Curedbio/Microscope/README.md

# Smartphone-Microscope
Microscope for any smartphone
