Curedbio/Microscope/V2/Microscopio_3mm_MDF_v021.pdf

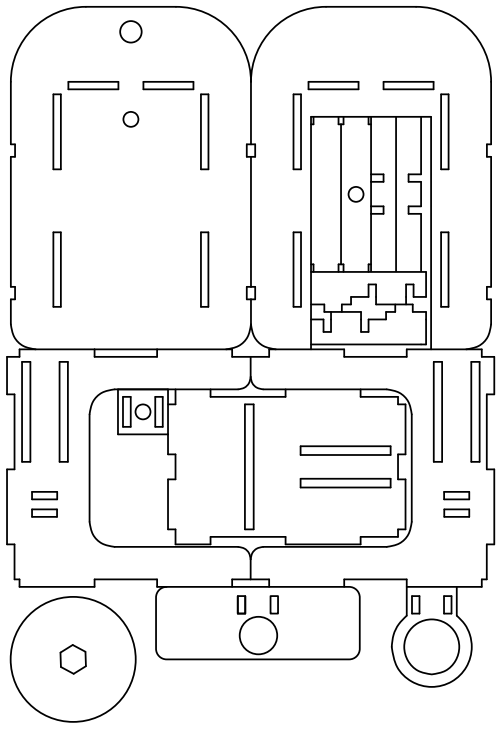
[picture p1: figure]
