Curedbio/Microscope/V1/model_v01.pdf

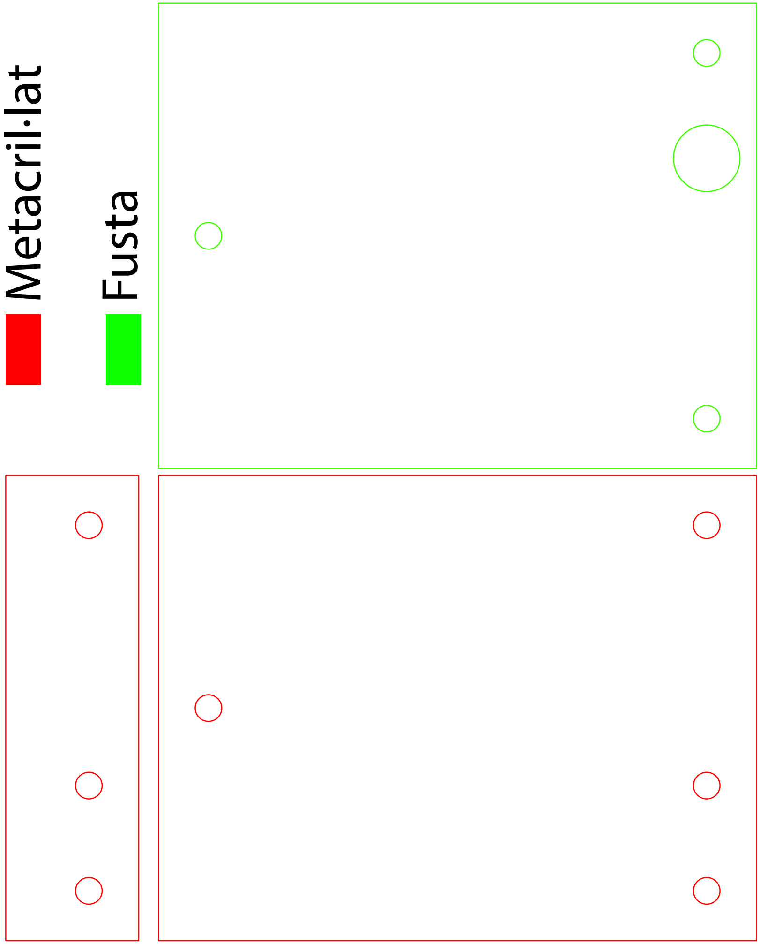
[picture p2: figure]
Metacril·lat; Fusta
