Curedbio/Microscope/V2/Microscopio_3mm_MDF_v021.dxf

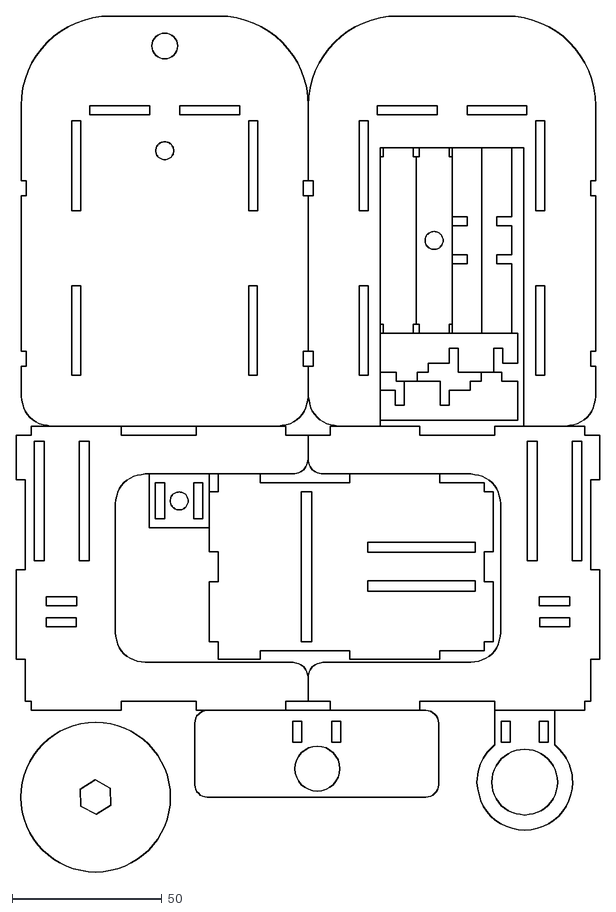
[picture p3: CAD file, 2019-03-04]
V2/Microscopio_3mm_MDF_v021.dxf
194.8 x 286.0
