Curedbio/Microscope/V2/STL/Microscopio_Lateral2_3.stl

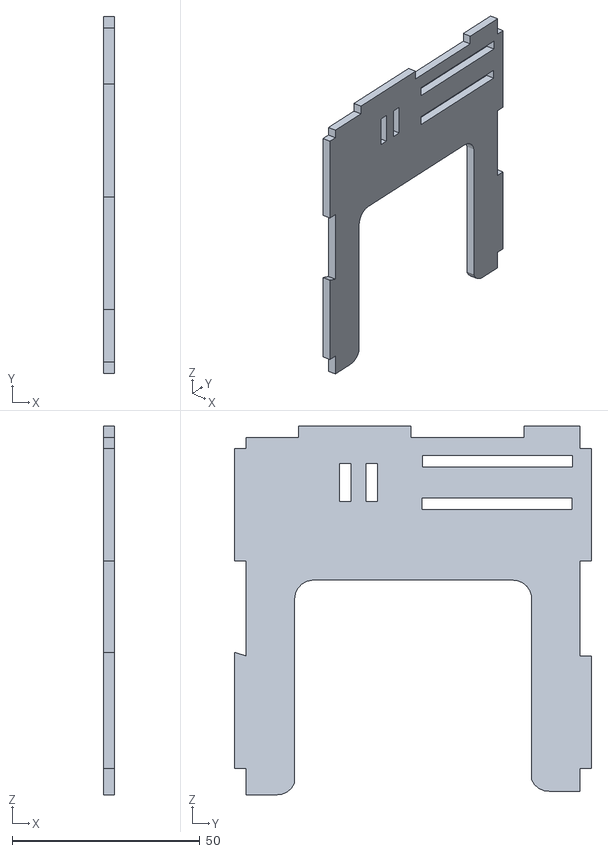
[picture p4: CAD file, 2018-02-19]
V2/STL/Microscopio_Lateral2_3.stl
3.00 x 95.0 x 98.1
