Curedbio/Microscope/V2/led_holder_v1-0.stl

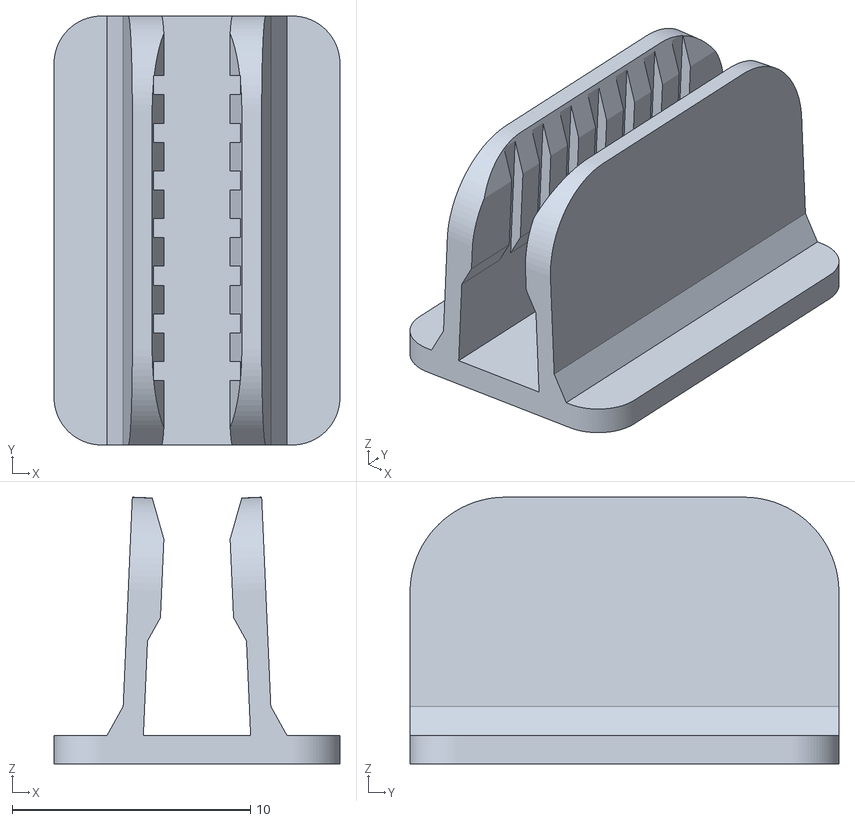
[picture p5: CAD file, 2019-03-04]
V2/led_holder_v1-0.stl
12.0 x 18.0 x 11.2
