Curedbio/Microscope/V2/STL/Microscopio_Support_Down_Down_5.stl

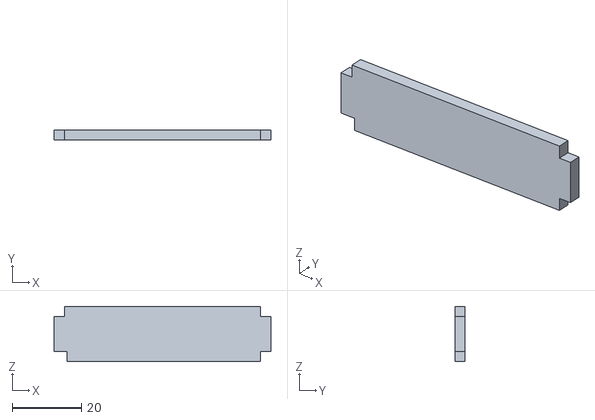
[picture p6: CAD file, 2018-02-19]
V2/STL/Microscopio_Support_Down_Down_5.stl
62.7 x 3.00 x 16.0
