Curedbio/Microscope/V2/STL/Microscopio_Wheel_6.stl

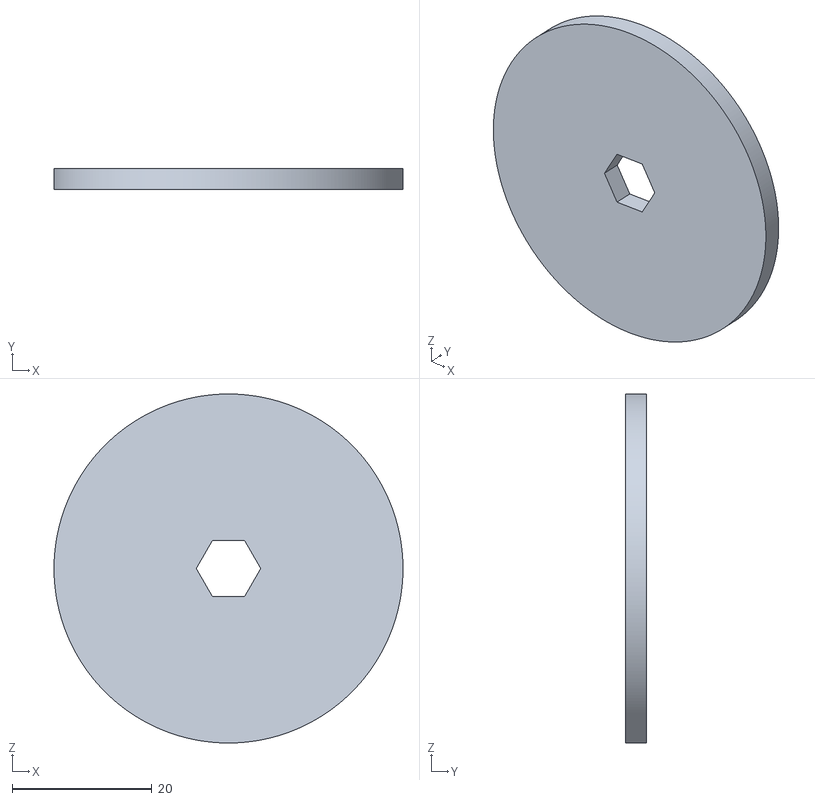
[picture p7: CAD file, 2018-02-19]
V2/STL/Microscopio_Wheel_6.stl
50.0 x 3.00 x 50.0
