Curedbio/Microscope/V2/STL/Microscopio_Square_Union_10.stl

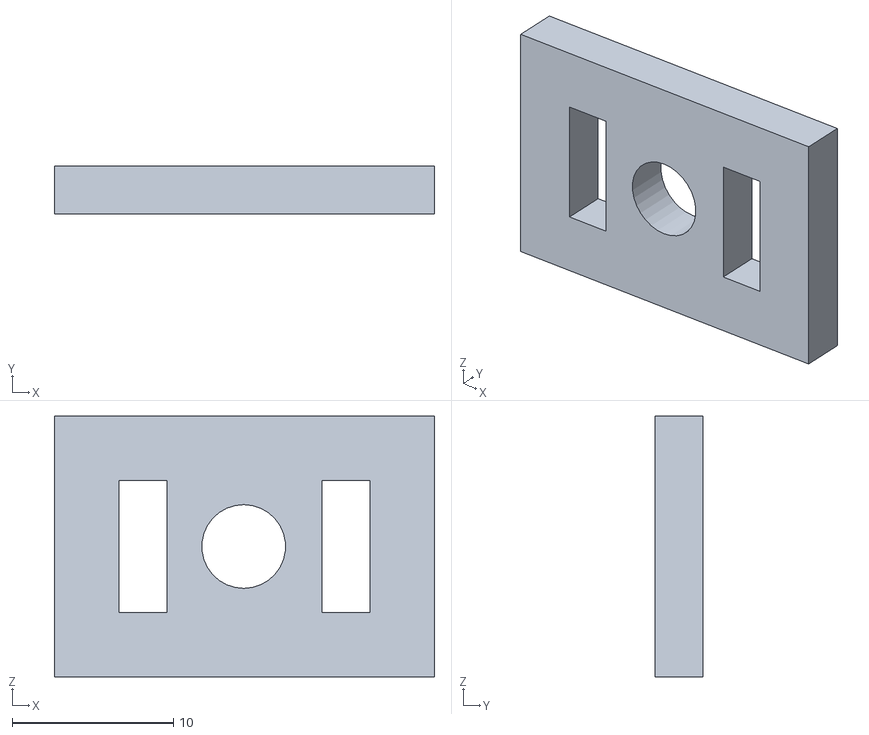
[picture p8: CAD file, 2018-02-19]
V2/STL/Microscopio_Square_Union_10.stl
23.6 x 3.00 x 16.2
