Curedbio/Microscope/V2/STL/Microscopio_Support_Trans_9.stl

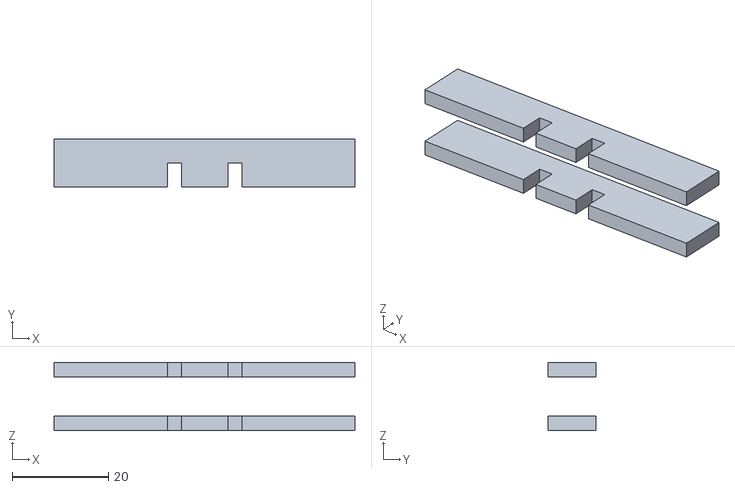
[picture p10: CAD file, 2018-02-19]
V2/STL/Microscopio_Support_Trans_9.stl
62.7 x 10.0 x 14.2
