Curedbio/Microscope/V2/STL/Microscopio_Slide_12.stl

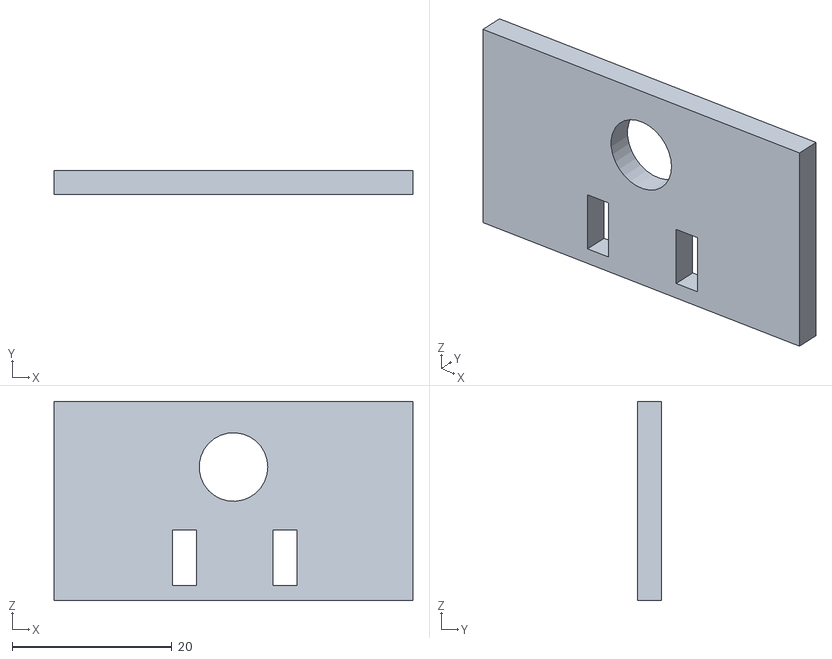
[picture p11: CAD file, 2018-02-19]
V2/STL/Microscopio_Slide_12.stl
45.0 x 3.00 x 25.0
