Curedbio/Microscope/V2/STL/Microscopio_Top_11.stl

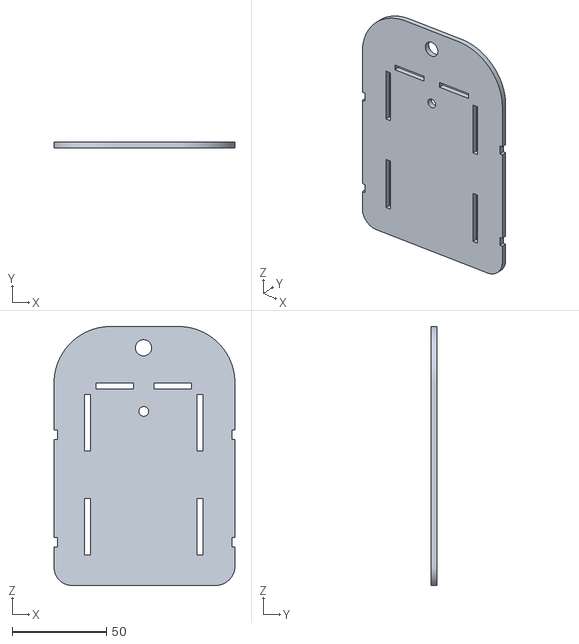
[picture p12: CAD file, 2018-02-19]
V2/STL/Microscopio_Top_11.stl
96.0 x 3.00 x 137.4
