Curedbio/Microscope/V2/STL/Microscopio_Support_Up_Left_8.stl

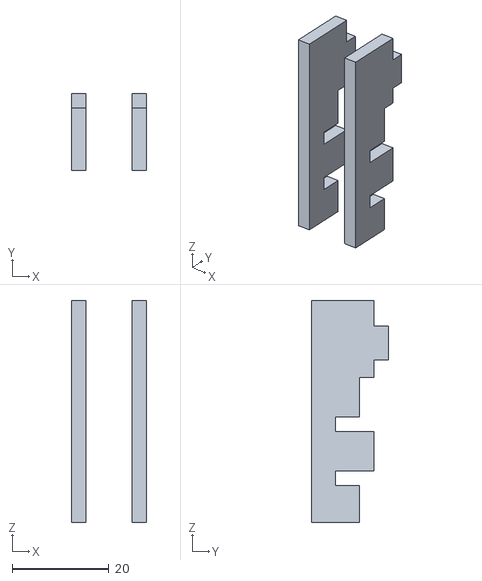
[picture p13: CAD file, 2018-02-19]
V2/STL/Microscopio_Support_Up_Left_8.stl
15.6 x 16.0 x 46.0
