Curedbio/Microscope/V2/STL/Microscopio_Frontal_4.stl

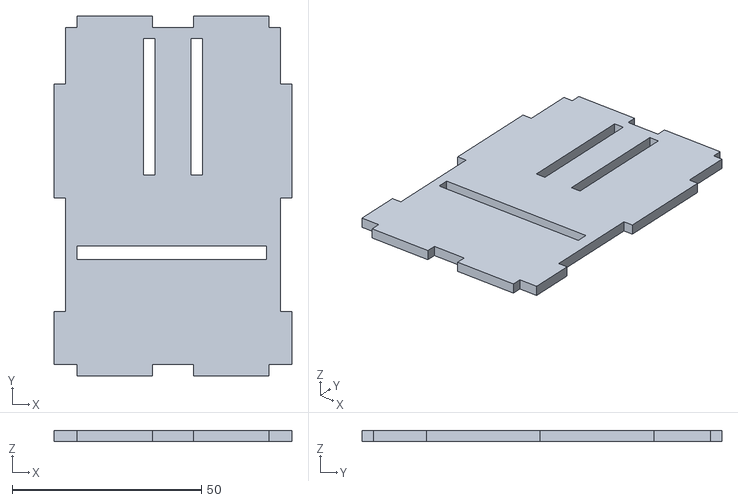
[picture p14: CAD file, 2018-02-19]
V2/STL/Microscopio_Frontal_4.stl
62.7 x 95.0 x 3.00
