Curedbio/Microscope/(list of files, cad)

Other CAD files:
V2/STL/Microscopio_Lateral1_2.stl
V2/STL/Microscopio_Support_Down_Up_7.stl
