Curedbio/Microscope/Assembly_guide_v012_ESP.pdf

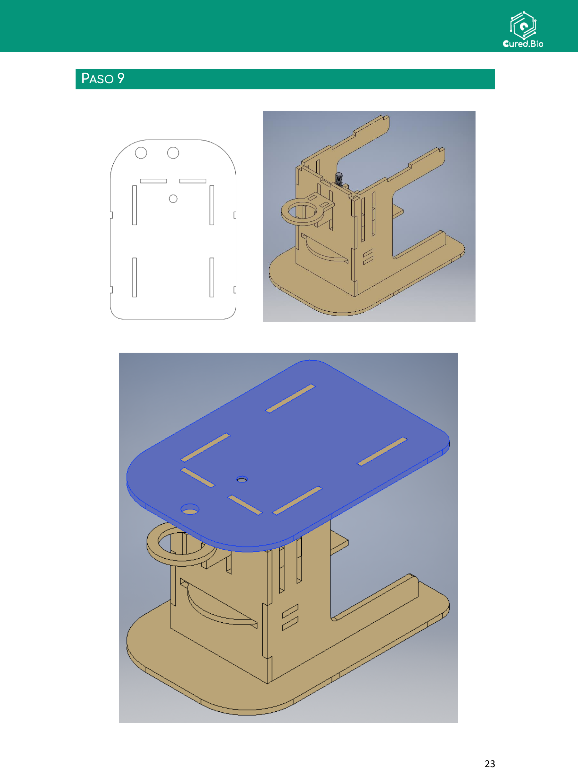
[picture p89: page 25]
