Curedbio/Microscope/Microscopy_Guide_Full_CAT_V1_V2.pdf

# SMARTPHONE MICROSCOPE

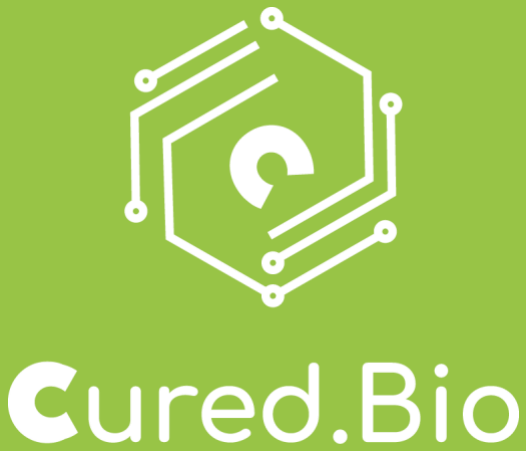
[picture p15: figure]

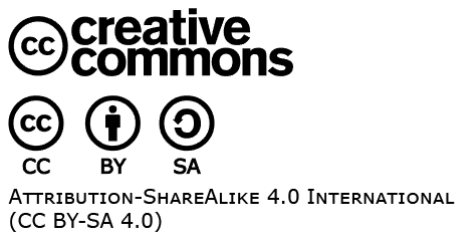
[picture p16: figure]

Smartphone Microscope
Derived from Microscopes by OpenStax Physics

Edited by Cured.Bio
Version 0.1.0
Barcelona, 2018

## ÍNDEX

# INTRODUCCIÓ A LA MICROSCÒPIA

INTRODUCCIÓ

Encara que l'ull és meravellós en la seva capacitat de veure objectes grans i petits, òbviament té limitacions als detalls més petits. El desig humà de veure més enllà del que és possible a simple vista va conduir al desenvolupament d'instruments òptics com el microscopi. Aquest instrument serveix per ampliar els detalls que no podem veure amb l’ull nu.

Bàsicament, un microscopi es un sistema de lents i/o miralls, on la imatge formada pel primer element es converteix en l'objecte del segon element, i així successivament. El microscopi mes basic consta de dues lents convexes.

### MICROSCOPI COMPOST

Els microscopis van ser desenvolupats a principis de 1600 per fabricants d'ulleres a Holanda i Dinamarca, amb el propòsit de visualitzar objectes petits mitjançant l’ús de diferents lents i/o miralls. El microscopi compost més simple es construeix a partir de dues lents convexes.

Una lent és un element, tradicionalment de vidre, destinat a fer convergir (concentrar) o divergir (dispersar) la llum. Les lents convexes són més gruixudes en el centre que no pas en els extrems. Aquestes lents fan convergir els raigs paral·lels en un punt anomenat punt focal (F’) i defineix la distància focal (f’), la qual es la distància entre el centre de la lent i el punt focal.

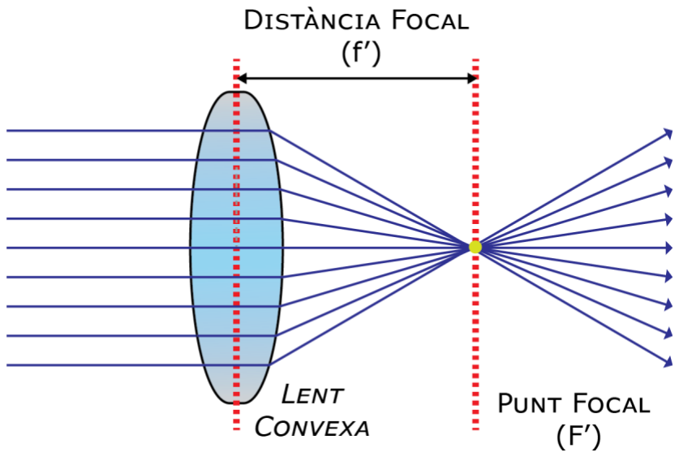
[picture p17: figure]

- Focus principal (F'): En una lent convergent el punt on coincideixen els raigs i per una divergent el punt con coincideixen les prolongacions del raig.
Tota lent té dos focus F i F'.
- Distància focal (f'): la distància des del focus al centre òptic

Potencia d’una lent
La diòptria és la unitat de mesura amb què s'expressa la potència d'una lent o d'un mirall corbat. Una lent convexa amb un major grau de curvatura, però fabricada amb el mateix material, tindrà una distància focal (f’) més curta i, per tant, serà una lent amb major capacitat de produir augments (diòptries, D).
La potència d'una lent es pot calcular utilitzant la següent fórmula:

D =

1
f

′

D’aquesta manera, una lent que té una distància focal de 0,1 metres té una potència de 10 diòptries.

Figura 1. Esquema lent convergent.

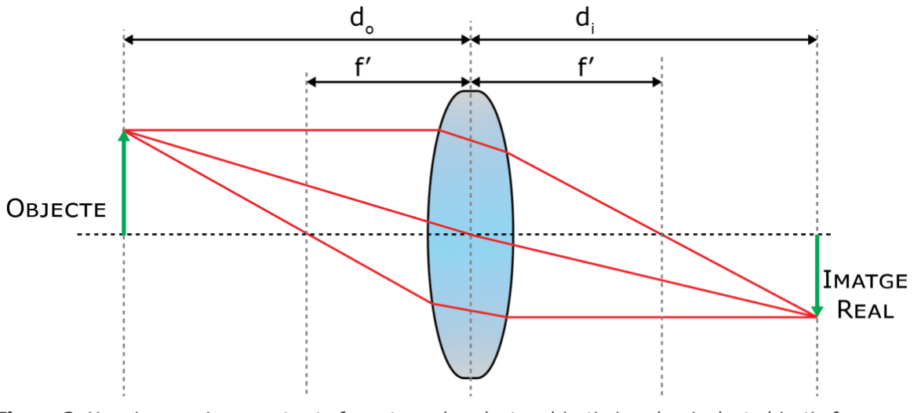
[picture p18: figure]

Figura 2. Un microscopi compost esta format per dues lents: objectiu i ocular. La lent objectiu forma una primera imatge més gran que l'objecte original. Aquesta imatge és ampliada per la lent ocular.

Si la distància des de un objecte fins l’objectiu es do i la distancia entre l’objectiu i la imatge creada es di, podem definir que:
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
Per tant, si un objecte es situat a una distància do>fo , es possible determinar a quina distancia es formarà la imatge (di).

En alguns casos di te un valor negatiu, la qual cosa indica que la imatge està formada al costat oposat de la lent des d'on s'estan considerant aquests raigs. Atès que els raigs de llum divergents que emanen de la lent no arriben mai a enfocar, i aquests raigs no estan físicament presents en el punt on semblen formar una imatge, això es coneix com una imatge virtual. Això és exactament el que fa l'ull quan mira a través d'una lupa. La lupa crea una imatge virtual (magnificada) darrere de la lupa, però aquests raigs es tornen a fotografiar per la lent de l'ull per crear una imatge real a la retina.

En un microscopi, la lent que es troba mes propera a la mostra s’anomena objectiu, i en microscopis normals sol tenir una ampliació de 5x a 100x i poden intercanviar-se. El segon, anomenat ocular, per trobar-se mes proper a l’ull, sol tenir una ampliació de 5x a 10x i es de tipus fix. Ambdues lents treballen de forma conjunta per a produir la imatge ampliada. A més, la imatge ampliada final es produeix en un lloc prou llunya per a que l'observador el pugui veure fàcilment, ja que l'ull no pot centrar-se en objectes o imatges massa properes.

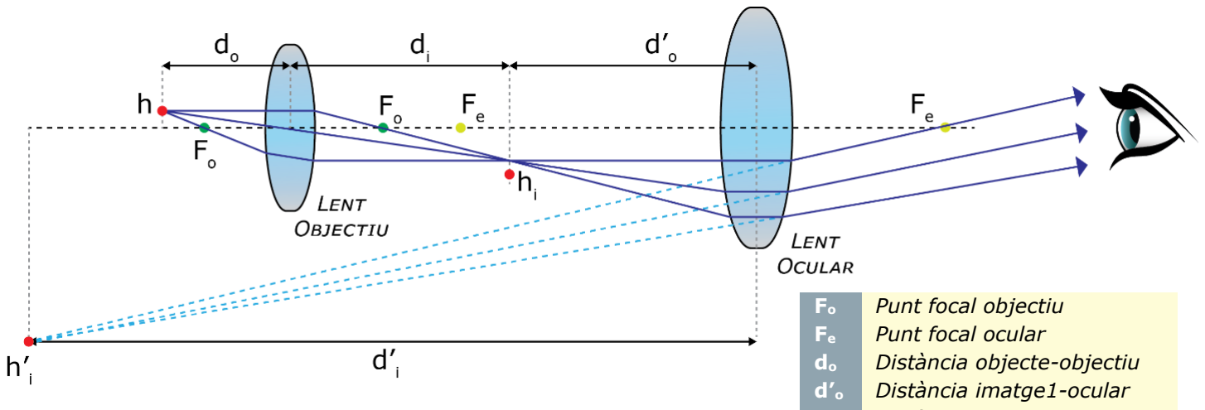
[picture p19: figure]
Punt focal objectiu; Punt focal ocular; Distància objecte-objectiu; Distància imatge1-ocular

Figura 3. Un microscopi compost esta format per dues lents: objectiu i ocular. La lent objectiu forma una primera imatge més gran que l'objecte original. Aquesta imatge és ampliada per la lent ocular.

Per entendre com un microscopi forma una imatge, tal com es mostra a la Figura 4, considerem dues lens convexes en successió. L’objecte (h) és troba a la distancia (d0) de la lent objectiu, que produeix una imatge real (hi) més gran que la mostra. Aquesta primera imatge (hi) és l'objecte de la segona lent (lent ocular). Aquesta lent esta situada per a què la primera imatge estigui més propera que la seva distància focal (Fe). D'aquesta manera, l'ocular actua com una lupa, i la imatge virtual es fa encara més gran.
La imatge virtual queda invertida, però és troba més allunyada de l'observador, cosa que facilita la visió (l'ull està més relaxat quan es visualitzen objectes distants i normalment no poden centrar-se més de 25 cm). Atès que cada lent produeix una ampliació , l'augment total
(m) és producte de les ampliacions individuals:

m = mo · me

on mo és l'augment de l'objectiu i me és l'augment de l'ocular. Aquesta equació es pot generalitzar per a qualsevol combinació de lents primes i miralls.

di | Distància objecte-objectiu
d’i | Distància imatge2-ocular
h | Objecte (mostra)
hi | Imatge real
h’i | Imatge virtual

### COM CALCULAR EL PODER D’AMPLIACIÓ D’UN MICROSCOPI

Calculeu l'ampliació (m) d'un objecte situat a 6.20 mm (do) d'un microscopi compost que té un objectiu amb una distancia focal de 6.00 mm (fo) i un ocular amb una distancia focal de 50.0 mm (d’i). L'objectiu i el ocular estan separats per 23.0 cm.

Estratègia i concepte
Aquesta situació és similar a la que es mostra a la Figura 3. Per trobar l'ampliació global, hem de trobar l'augment de la len ocular (mo) i el del la lent objectiu (me). Això implica l'ús de les equació esmentades.

Solució
L'augment de la lent objectiu es dóna com a

### m = mo · me

On la capacitat d’augment ve determinat per les diòptries (D) de la lent

D =

1
f

′

I on do es la distància focal de l’objectiu i di la distància la que es troba la imatge (hi), per a la len objectiu tal com s'indica a la Figura 4. La distància a la que es troba l’objecte es de 6.20 mm, però la distància a la que es produeix la imatge (di) no és coneguda. I on Fo és la distància focal de la lent objectiu.

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
Aïllant di, tenim que:

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
Per tant, podem definir m0 com a:
m0 = −

di
do

1
di

=

1
6. 00 mm

−

1
6. 20 mm

=

0. 00538
mm

Resolem i, per tant, di= 185.87 mm ≈ 186 mm.

Substituint aquest valor a l’equació per a mo,

m0 = −

di
do

= −

186 mm
6. 20 mm

= −30. 0

Ara, cal trobar l’ampliació de la len ocular (me), la qual ve donada per

me = −

di

′
do

′

on di' i do' són les distàncies d'imatge i objecte per a l'ocular (Figura 3). La distància de l'objecte és la distància de la primera imatge de l'ocular. Com que la primera imatge és a 186 mm de l'objectiu i l'ocular és a 230 mm respecte l'objectiu, la distància de l'objecte és (230 mm - 186 mm) de 44.0 mm. Això implica que la primera imatge es troba propera a l'ocular que la seva distància focal, de manera que l'ocular formarà una imatge (hi), tal com es mostra a la figura.

Per conèixer la ubicació de la imatge final, cal repetir les passes anterior per obtenir un valor de 1/di':

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
50. 0 mm

−

1
44. 0 mm

= −

0. 00273
mm

Resolem i, per tant, d’i = -366.30 mm ≈ -367 mm. Tornem a la primera equació i resolem per me,

me = −

di

′
do

′

= −

−367 mm
44 mm

= 8. 33

Ja nomes queda resoldre l’equació general,

## m = mo

- me = (−30. 0) · (8. 33) = −250

Discussió
Tant l'objectiu com l'ocular contribueixen a l'ampliació global, que és gran i negativa, d'acord amb la Figura 3, on la imatge es virtual i invertida. La imatge final és de 367 mm (0.367 m), formada a l'esquerra de l'ocular.
El procediment utilitzat per resoldre aquest exemple és aplicable en qualsevol sistema d'elements múltiples. Cada element es tracta respecte al seu torn, i cada un d'ells forma una imatge que es converteix en l'objecte del següent element.

# SMARTPHONE MICROSCOPE

### DESCRIPCIÓ

L’ Smartphone Microscope es un dispositiu open-source fabricat en fusta. Mitjançant l’ús d’una lent de 175x augments, es possible transformar qualsevol smartphone en un microscopi portàtil.
L’ Smartphone Microscope esta dissenyat per a poder ser ensamblat sense cap eina. A mes, es possible desensamblar-lo, facilitant el seu emmagatzematge (135x95x20mm). En cas de desitjar una estructura fixe, es recomana utilitzar cola d’enganxar o hot-glue.
No requereix instal·lar cap aplicació addicional, tan sols cal utilitzar alguna aplicació per fer fotografies o vídeos.
La qualitat de la imatge obtinguda depèn, en gran mesura, de les capacitats de la càmera de l’smartphone.

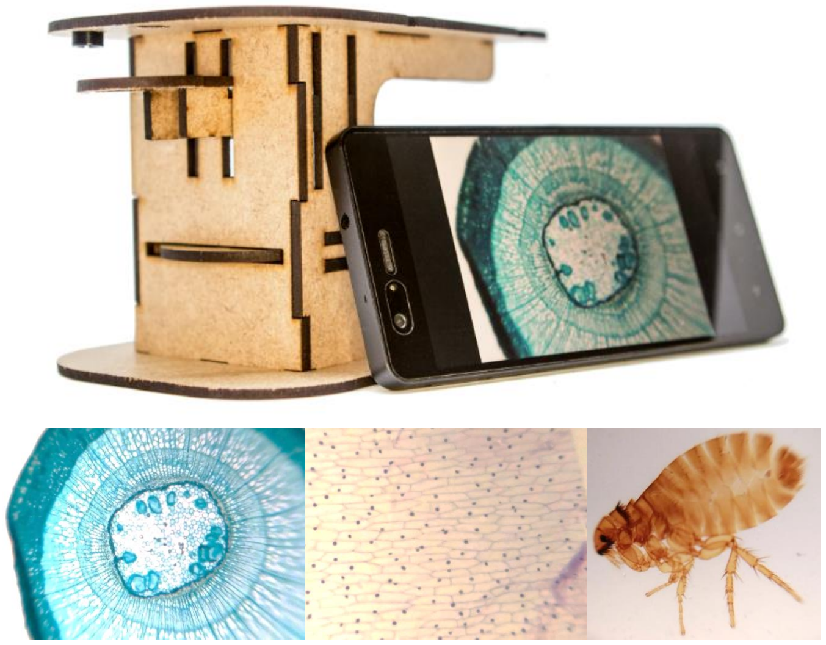
[picture p20: figure]

Imatges capturades amb BQ M5 i Open Camera v1.42

### COM FABRICAR-LO

L’Smartphone Microscope ha estat dissenyat per a poder ser fabricat mitjançant tècniques de fabricació tradicional o digital, ja sigui amb l’ajut d’una impressora 3D o una talladora làser.

Si es desitja seguir un mètode mes tradicional, cal adquirir fusta DM de 3mm de gruix, una mida similar a un DINA4. Aquest tipus de fustes es poden trobar Servei Estació (Barcelona) o grans magatzems (Leroy Merlin). Addicionalment, cal paper carbó per a calcar el disseny de les peces. Posteriorment, amb una serreta i paper de vidre poden retallar-se totes les peces necessàries.

En cas contrari, si es desitja utilitzar mètodes de fabricació digital, es pot utilitzar una impressora 3D o una talladora làser.
Si es disposar d’una impressora 3D, nomes cal imprimir els fitxers STL en plàstic PLA al 20% de refill. Depenent de la impressora, pot comportar mes o menys hores imprimir totes les peces.
Si es disposa d’una talladora làser, nomes cal utilitzar el fitxer PDF. Pot utilitzar-se fusta DM o metacrilat, ambdós de 3mm de gruix. El temps necessari depèn de la talladora làser utilitzada.

En cas de no disposar de cap de les dues, cal ser conscient que existeixen diferents entitats que poden oferir ambdós serveis. Tot i així, es recomana utilitzar una talladora làser. Alguns del llocs que podeu recórrer a Barcelona son:

- MADE MakerSpace: made-bcn.org
- Ateneus de fabricació: ajuntament.barcelona.cat/ateneusdefabricacio
- Punt Multimèdia: puntmultimedia.org

Trobareu els fitxers necessaris a www.github.com/curedbio.
Qualsevol dubte o petició, podeu contactar per mitja del correu electrònic info@cured.bio.

### COMPONENTS I ENSAMBLATGE

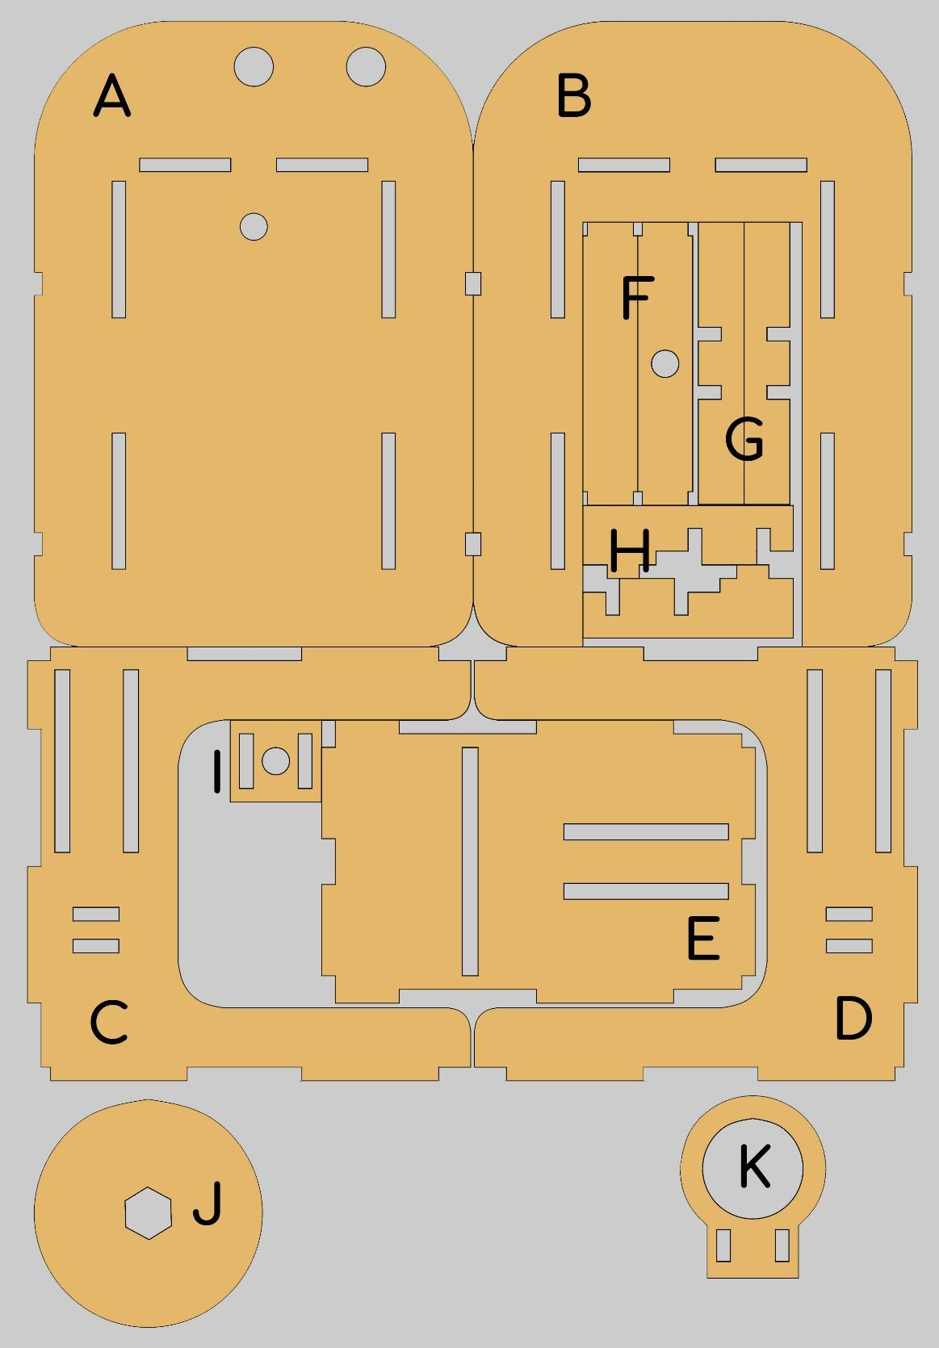
[picture p21: figure]

## M6*60mm

hexagonal | Femella M5 | Len

1

## Components G, H, I, rosca M5 hexagonal

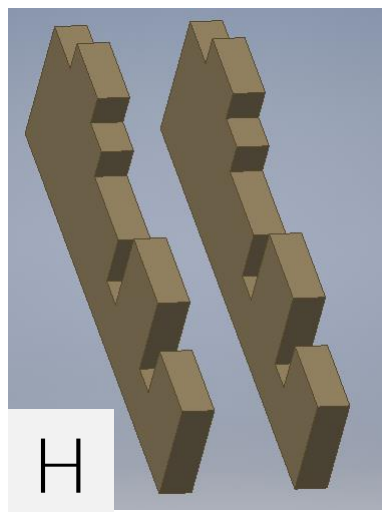
[picture p22: figure]
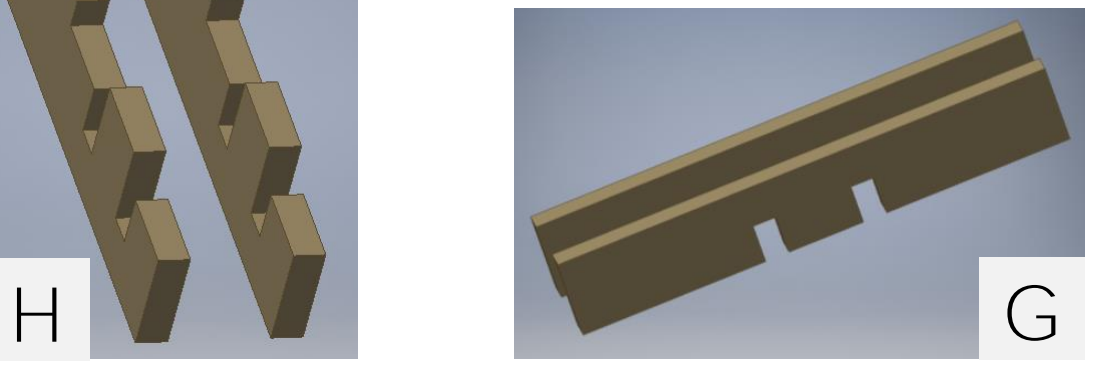
[picture p23: figure]
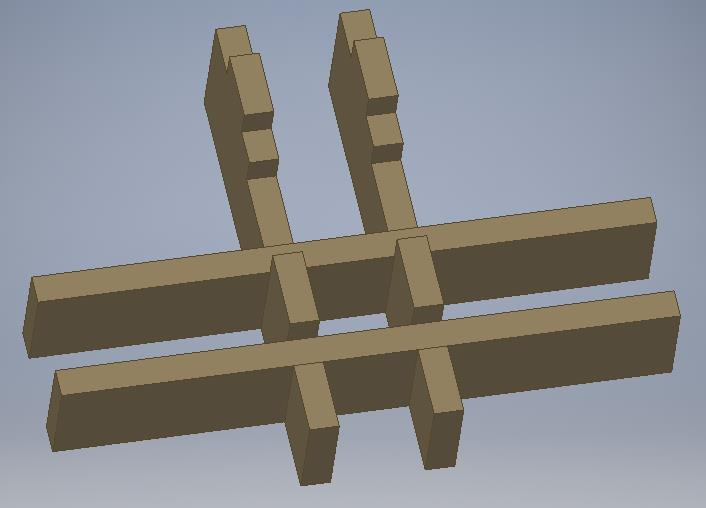
[picture p24: figure]
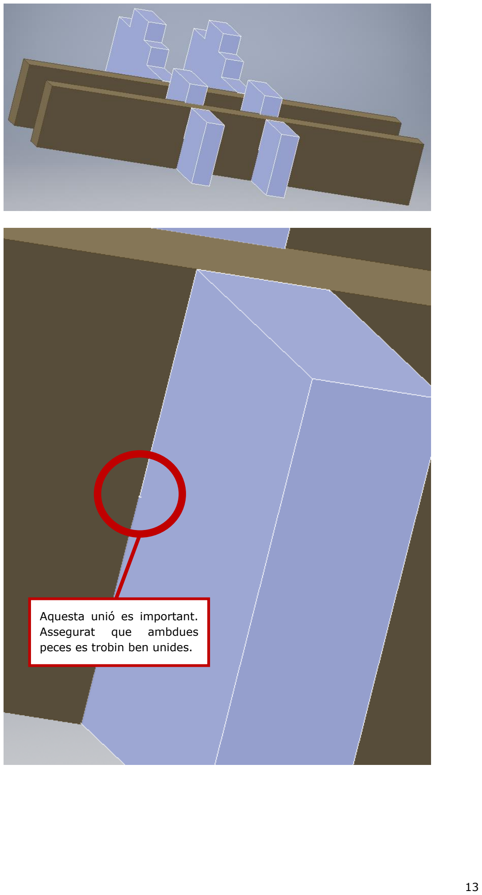
[picture p25: page 14]

Aquesta unió es important.
Assegurat | que | ambdues
peces es trobin ben unides.

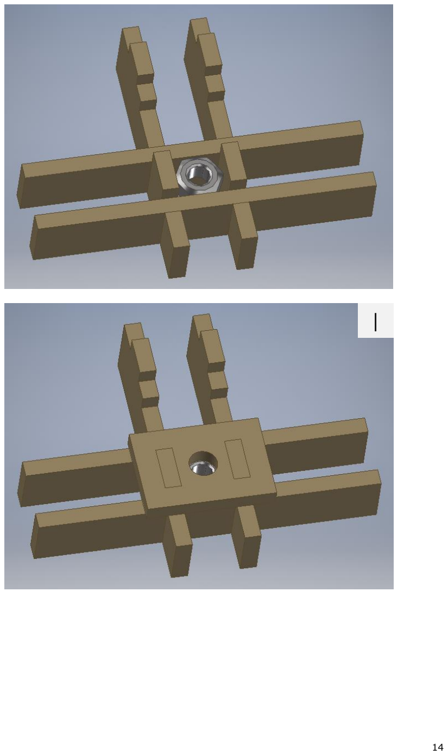
[picture p26: page 15]

I

2

## Components J, K, M6*60mm hexagonal

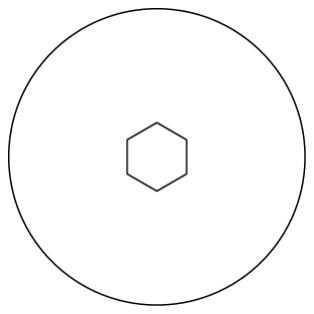
[picture p27: figure]
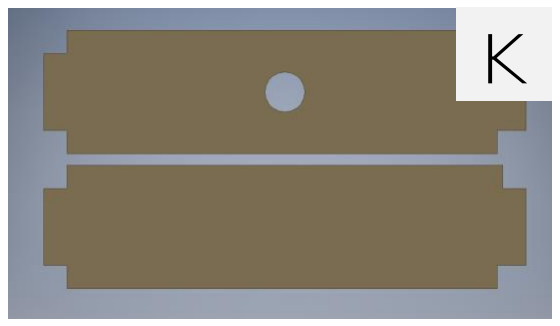
[picture p28: figure]
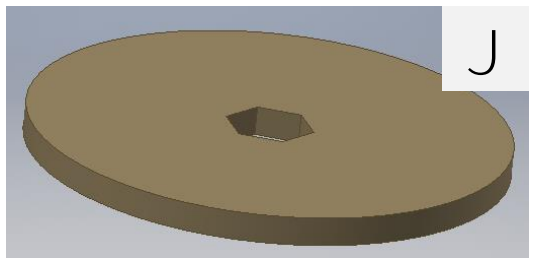
[picture p29: figure]
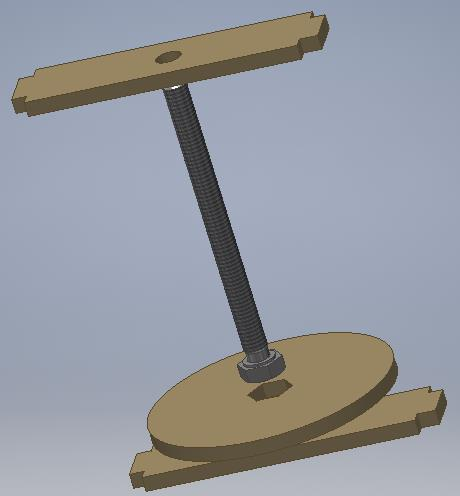
[picture p30: figure]
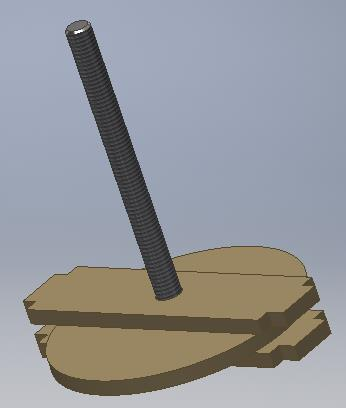
[picture p31: figure]

3

## Components 1, 2

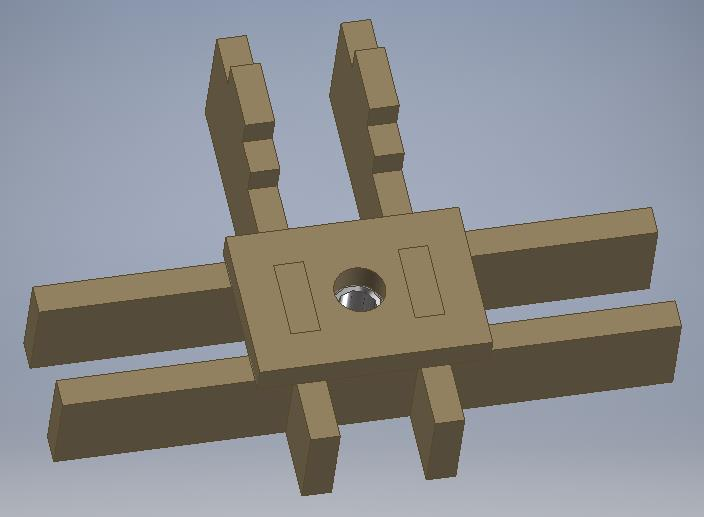
[picture p32: figure]
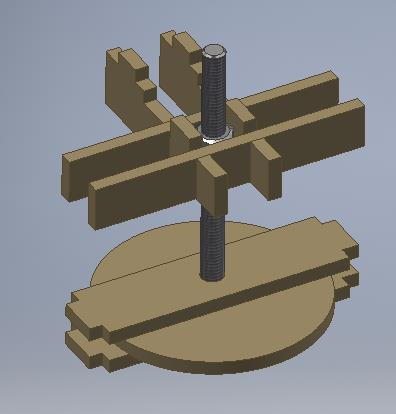
[picture p33: figure]

4

## Components E, 3

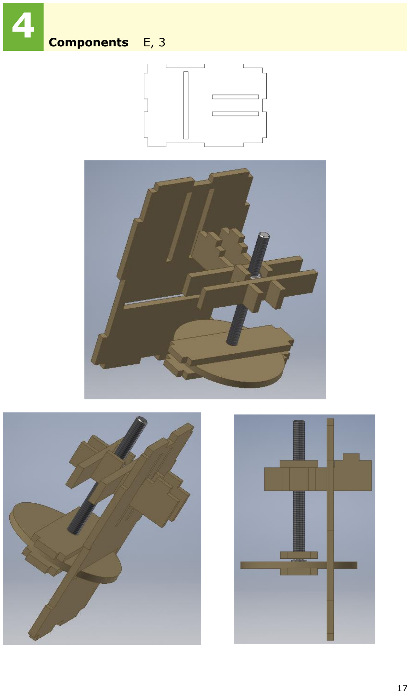
[picture p34: page 18]

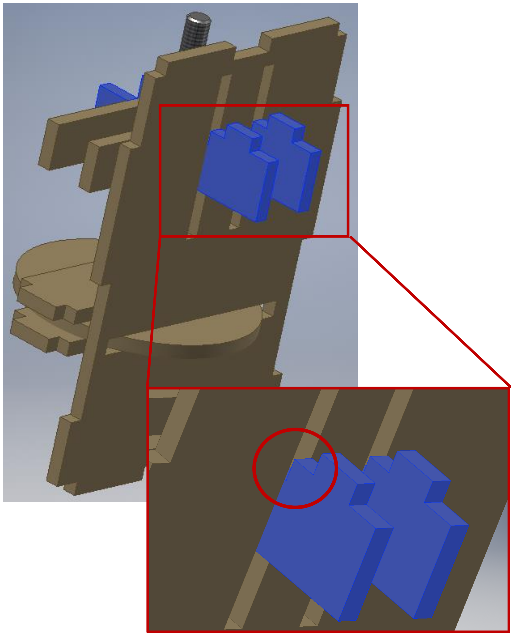
[picture p35: figure]

5

## Components C, D, 4

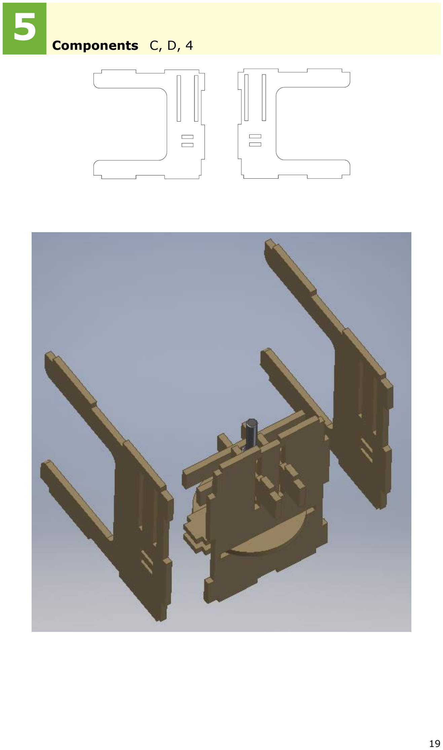
[picture p36: page 20]
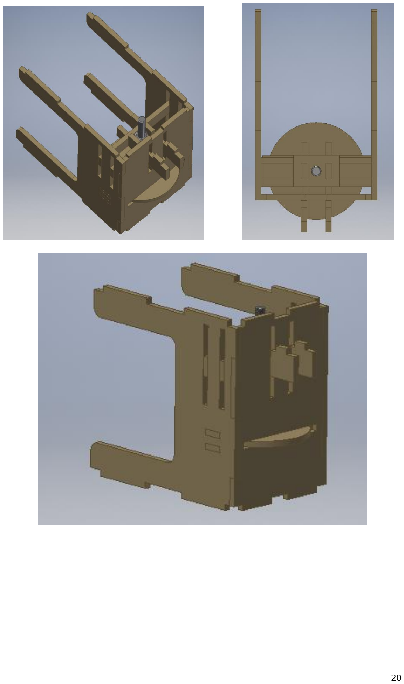
[picture p37: page 21]

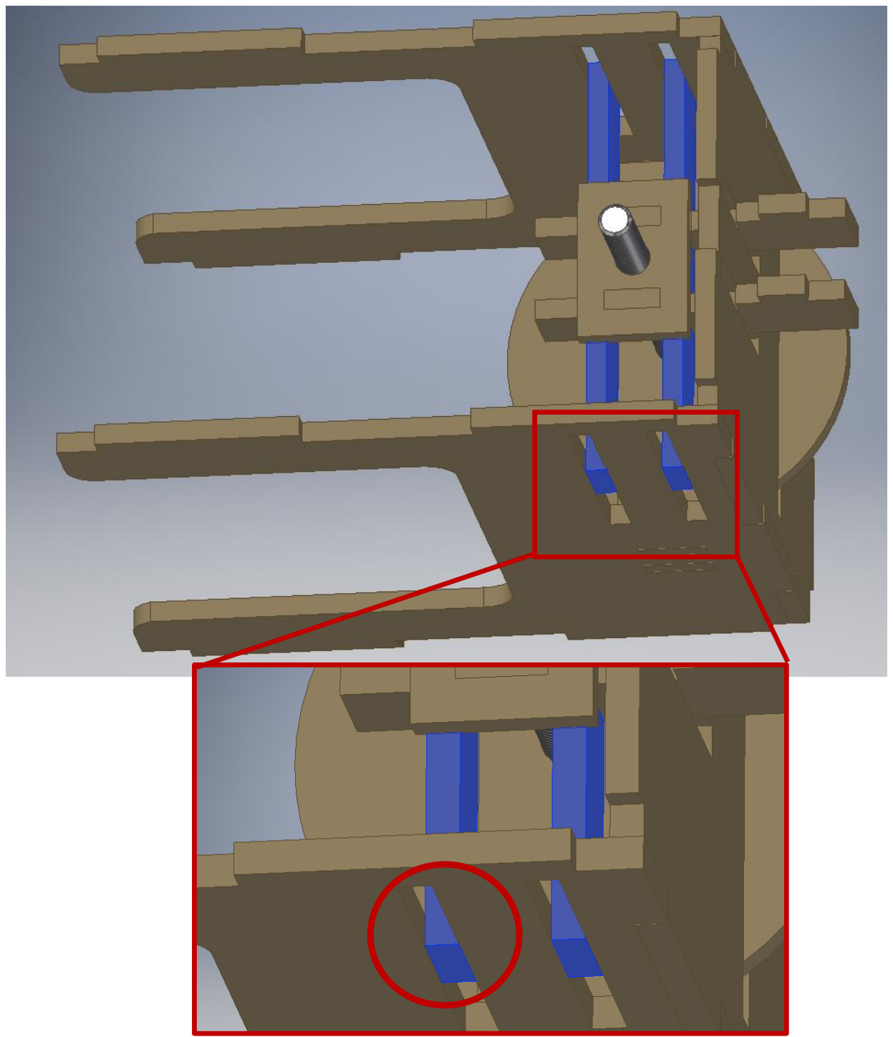
[picture p38: figure]

6

## Components A, B, 5, Len

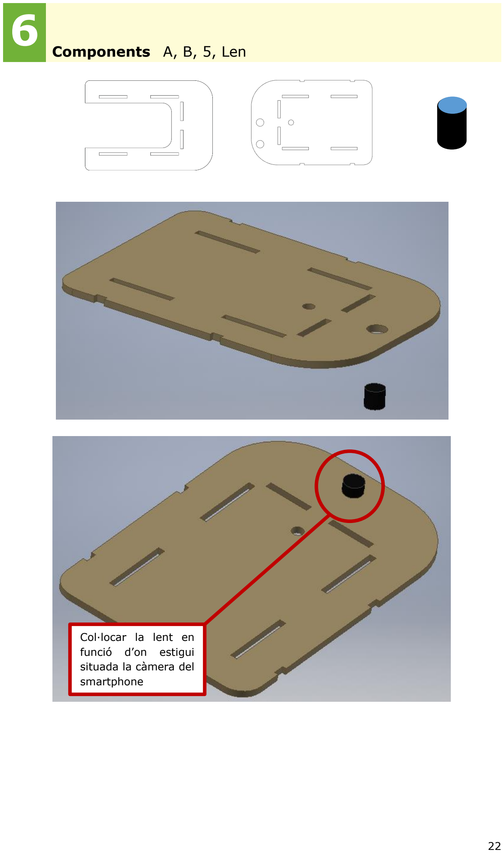
[picture p39: page 23]

Col·locar la lent en
funció d’on estigui
situada la càmera del
smartphone

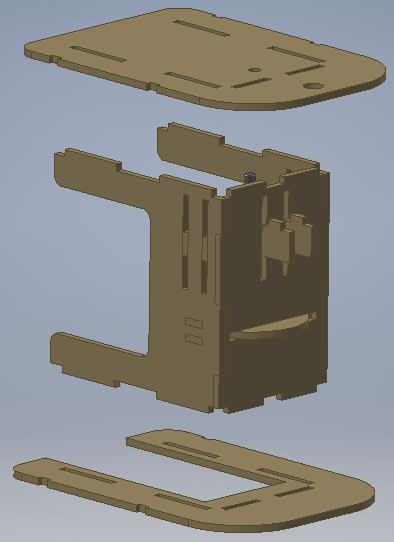
[picture p40: figure]
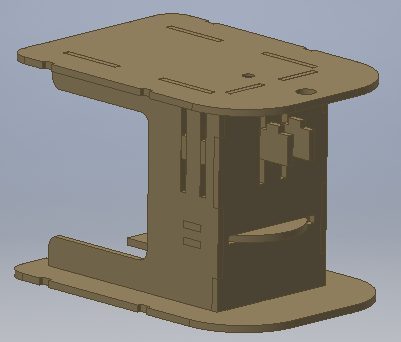
[picture p41: figure]

7

## Components K, 6

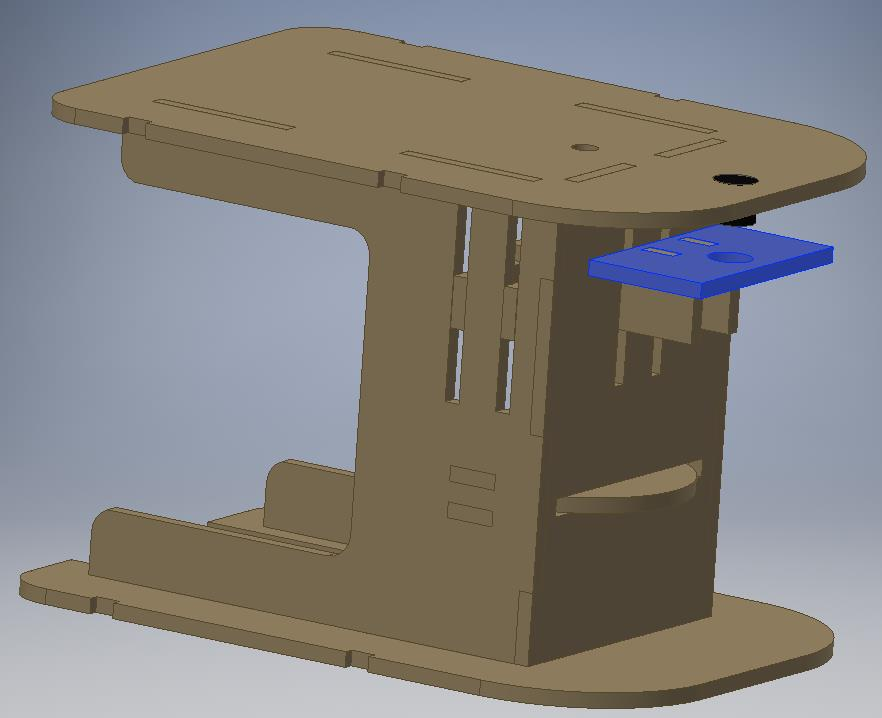
[picture p42: figure]

## 8 Observar el món microscòpic

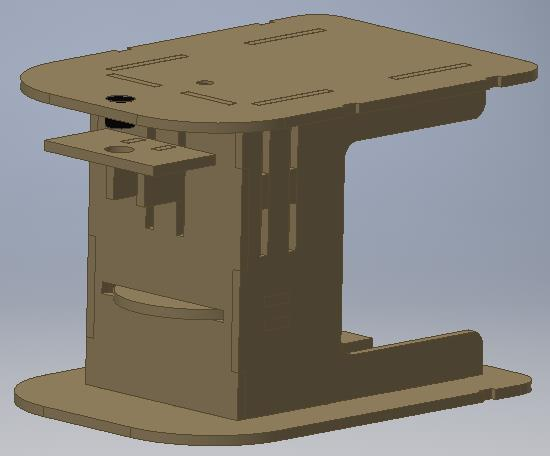
[picture p43: figure]

### MÒDUL LLUM

Smartphone Microscope esta dissenyat per a no requerir l’ús de llum directe. Tot i així, pot resultar interessant per als usuaris afegir un punt addicional de llum, per tal de millorar el contrast o visualitzar la mostra amb alguna longitud d’ona d’interès.

Una manera senzilla d’afegir un punt de llum es mitjançant una pila i un LED. De tal manera que es necessita:

### - Porta piles vertical CR2032 - Pila CR2032 - LED 3mm (llum blanca, per defecte)

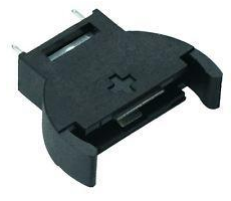
[picture p44: figure]
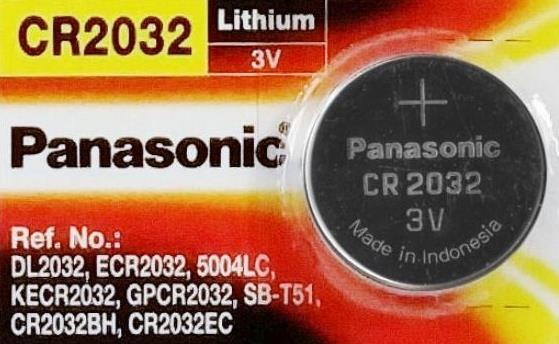
[picture p45: figure]

Cal clavar el porta piles a la base del microscopi, tal com es mostra en les figures que es troben a continuació.
Al col·locar el LED, cal vigilar amb el càtode (+) i l’ànode (-). Si al visualitzar la mostra, existeix un excés de llum, podem moure el LED o interposar algun full per reduir-ne la intensitat.

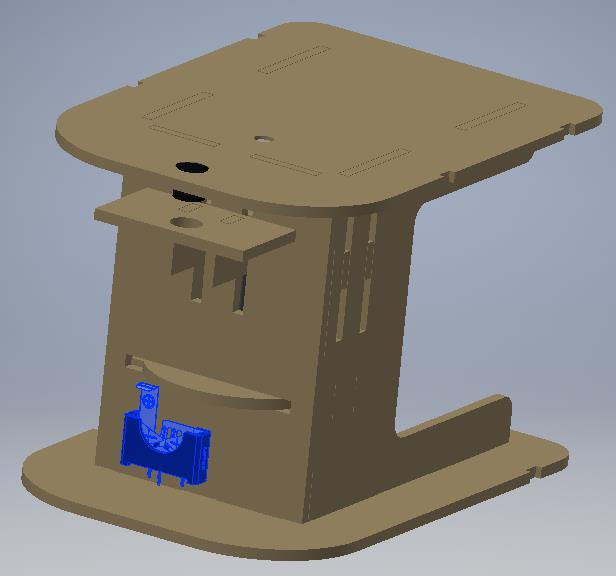
[picture p46: figure]
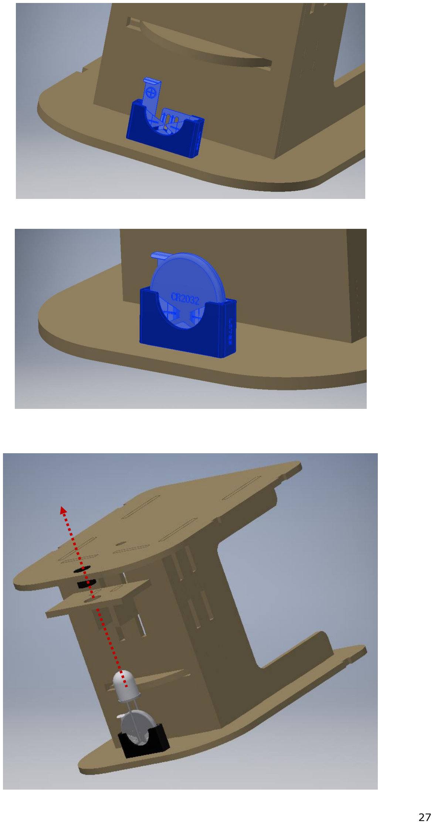
[picture p47: page 28]
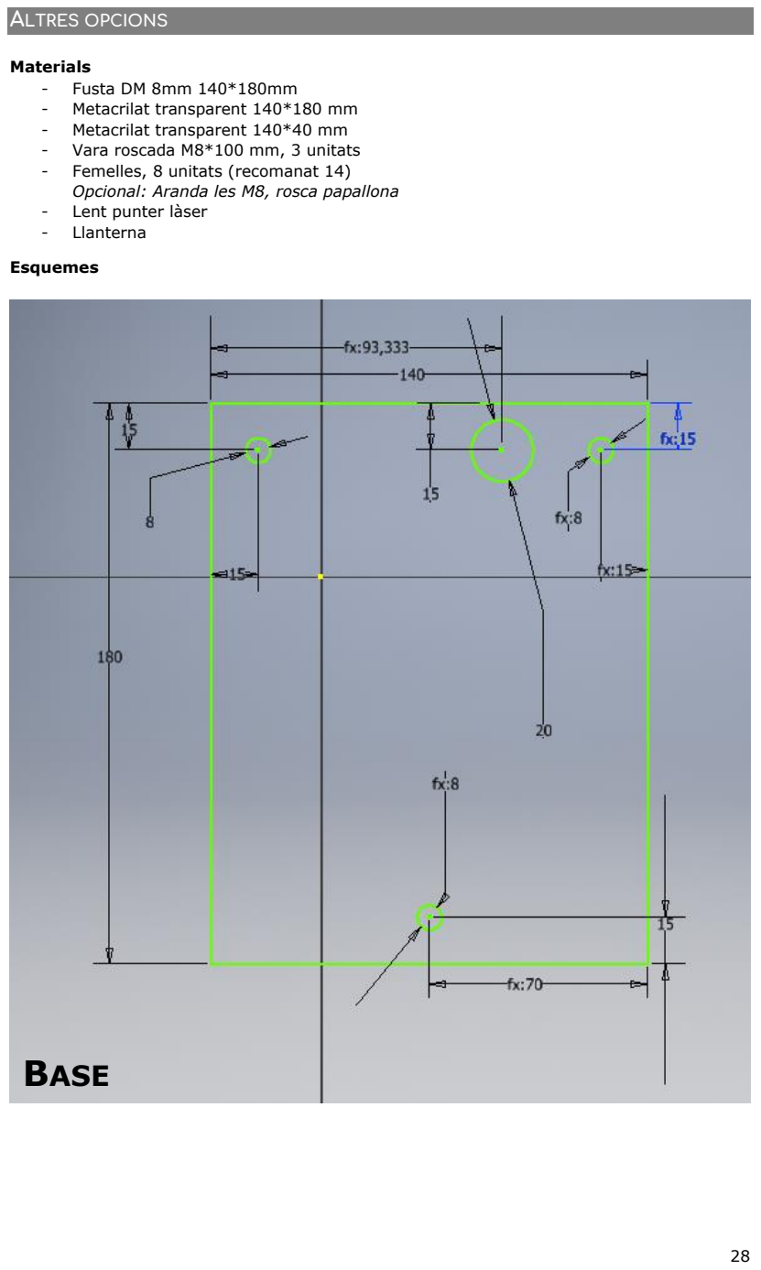
[picture p48: page 29]

### ALTRES OPCIONS

Materials
- Fusta DM 8mm 140*180mm
- Metacrilat transparent 140*180 mm
- Metacrilat transparent 140*40 mm
- Vara roscada M8*100 mm, 3 unitats
- Femelles, 8 unitats (recomanat 14) Opcional: Aranda les M8, rosca papallona
- Lent punter làser
- Llanterna

Esquemes

# BASE

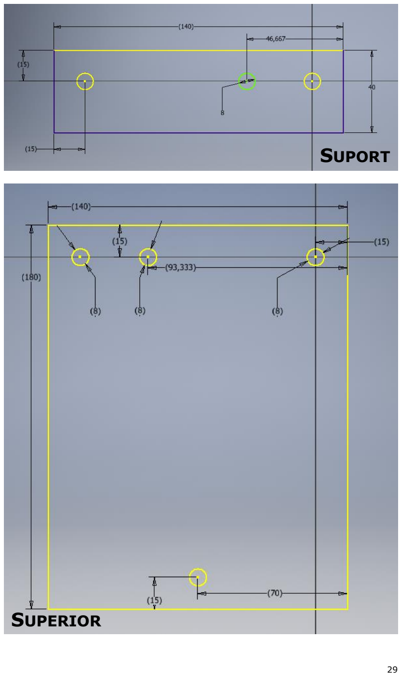
[picture p49: page 30]

# SUPORT

# SUPERIOR

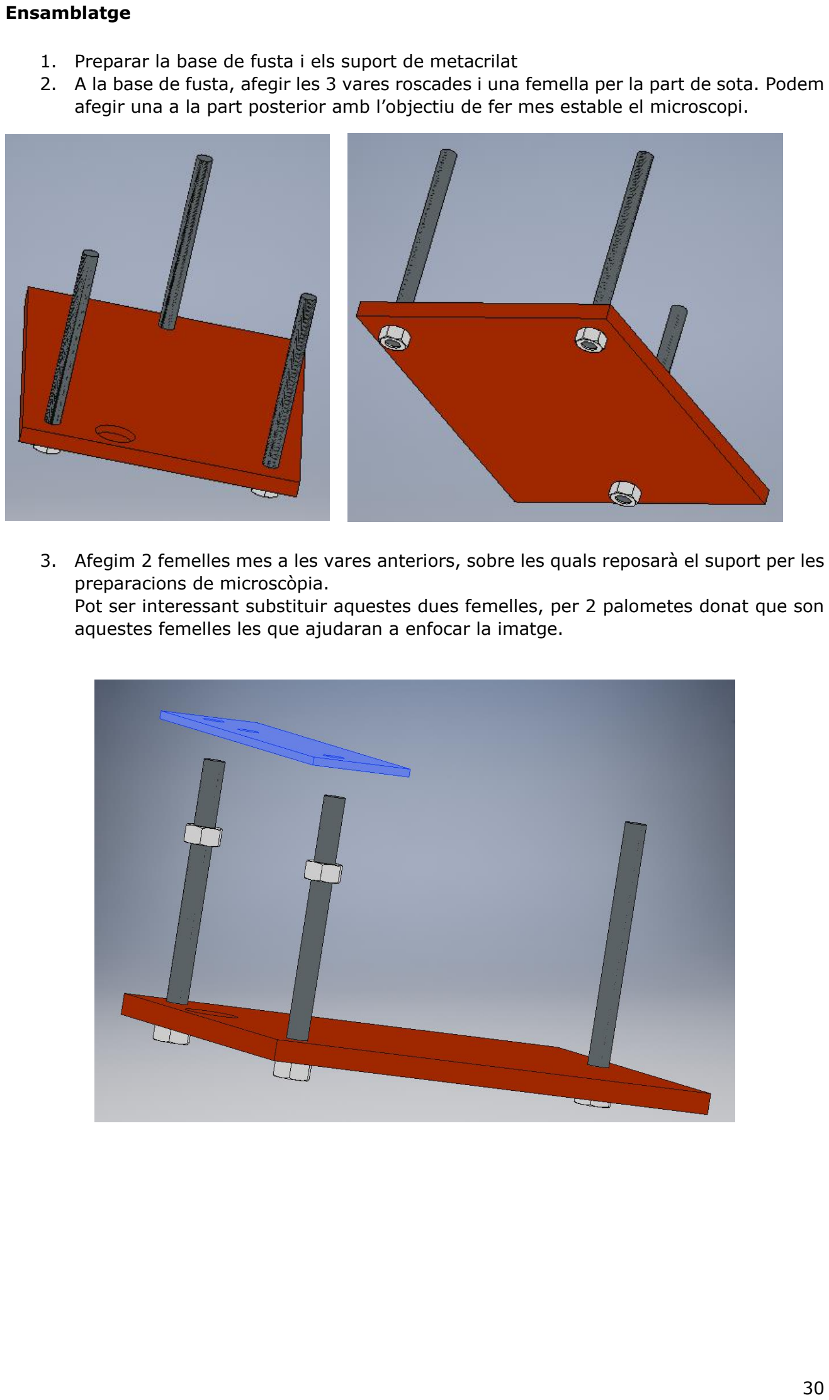
[picture p50: page 31]

Ensamblatge

1. Preparar la base de fusta i els suport de metacrilat
2. A la base de fusta, afegir les 3 vares roscades i una femella per la part de sota. Podem afegir una a la part posterior amb l’objectiu de fer mes estable el microscopi.
3. Afegim 2 femelles mes a les vares anteriors, sobre les quals reposarà el suport per les preparacions de microscòpia.
Pot ser interessant substituir aquestes dues femelles, per 2 palometes donat que son aquestes femelles les que ajudaran a enfocar la imatge.

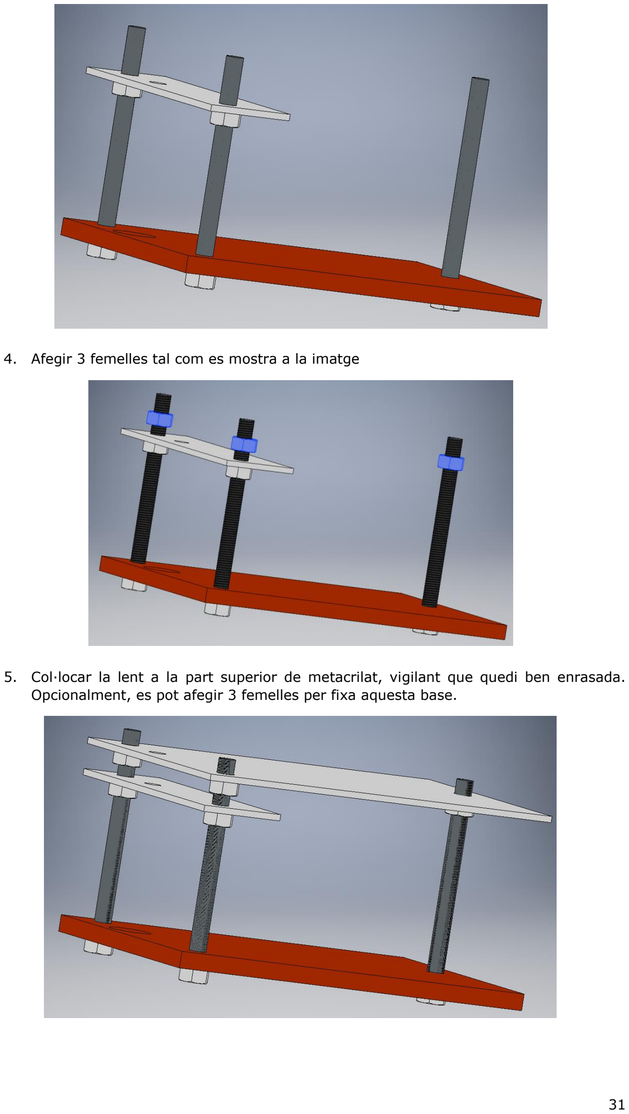
[picture p51: page 32]

4. Afegir 3 femelles tal com es mostra a la imatge
5. Col·locar la lent a la part superior de metacrilat, vigilant que quedi ben enrasada. Opcionalment, es pot afegir 3 femelles per fixa aquesta base.

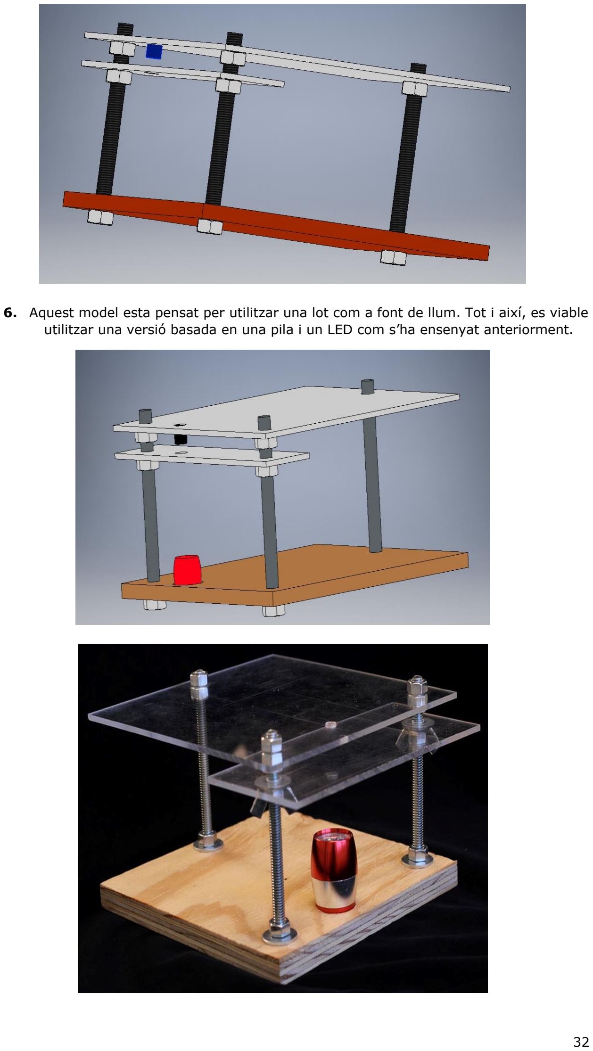
[picture p52: page 33]

6. Aquest model esta pensat per utilitzar una lot com a font de llum. Tot i així, es viable utilitzar una versió basada en una pila i un LED com s’ha ensenyat anteriorment.

Com obtenir una lent per al microscopi

Donat un punter lasar qualsevol, podem utilitzar la len convexa que incorpora per al microscopi.

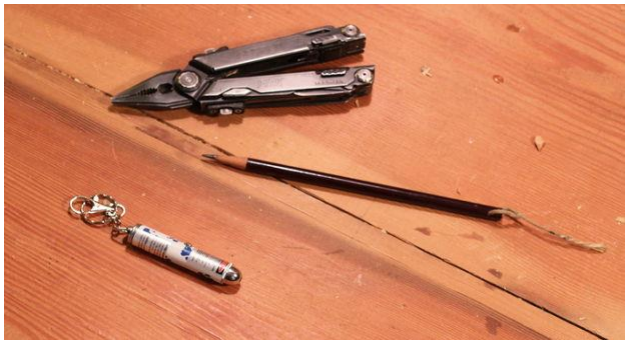
[picture p53: figure]
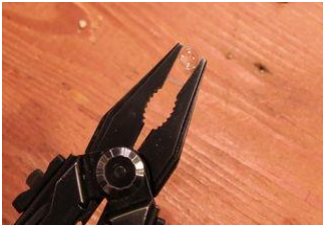
[picture p54: figure]

# PREPARACIONS PER AL MICROSCOPI

### CÈL·LULA ANIMAL: EPITELI MUCOSA ORAL

Les cèl·lules animals poden tenyir-se fàcilment mitjançant el blau de metilè. Aquest fet es degut a la permeabilitat de les seves membranes cel·lulars. El blau de metilè interacciona amb les molècules amb carrega negativa, com el DNA o el RNA.

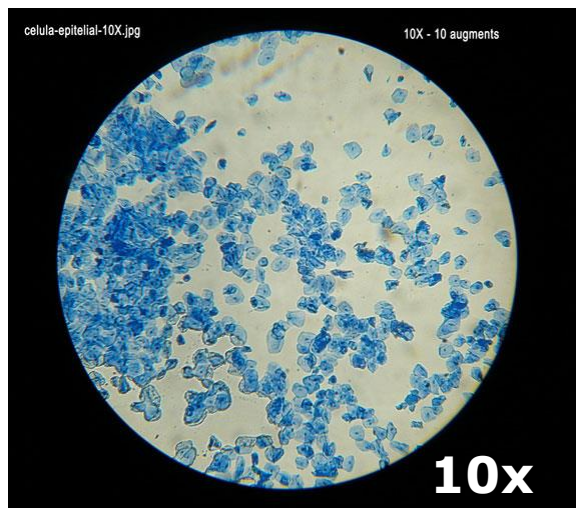
[picture p55: figure]

Materials
- Microscopi

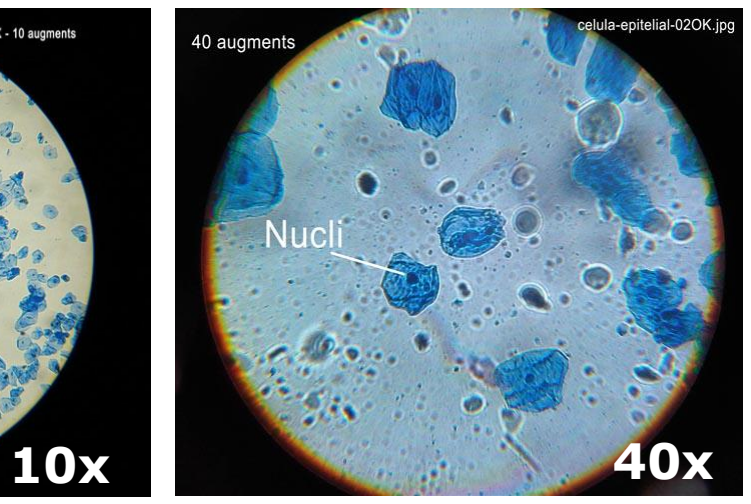
[picture p56: figure]

- Bastonet de cotó / Escuradents
- Portaobjectes i cobreobjectes
- Blau de metilè (0.5-1.0% solució stock, diluir a 1:4 amb H20).
- Bec bunsen
- Aigua destil·lada
- Pinces de fusta
- Vidre de rellotge / Placa de Petri

Protocol
1. Raspar amb un escuradents la mucosa interna de la galta de la boca, dipositant el producte extret en el centre d'un portaobjectes amb una gota d'aigua.
2. Realitzar una extensió més o menys uniforme, amb l'ajuda d'una agulla o un altre porta
3. Amb l’ajut d'unes pinces de fusta, escalfar suaument el portaobjectes per fixar la mostra, passant-lo per la flama de l'encenedor fins a la dessecació de l'extensió i evitant que el portaobjectes es s’escalfi excessivament (comprovar amb dors de la mà).
4. Col·locar el portaobjectes sobre el vidre de rellotge (o placa Petri) i afegir unes gotes de blau de metilè sobre l'extensió.
5. Incubar 2 minuts a temperatura ambient, i després rentar amb aigua destil·lada.
6. Retirar l’ excés d’aigua amb una mica de paper de filtre, per capil·laritat no arrossegament.
7. Observar la mostra al microscopi.

### CÈL·LULA VEGETAL: EPIDERMIS VEGETAL

La principal diferencia entre les cèl·lules animals i les vegetals rau en la membrana cel·lular. Primer de tot, realitzarem, una tinció de les cèl·lules per tal de visualitzar l’estructura del teixit. Posteriorment, s’observarà al microscopi com afecta la pressió osmòtica a les cèl·lules vegetals. Recorda que la concentració salina elevada (hipertònica) del medi fa que les cèl·lules perdin aigua per intentar equilibrar les concentracions interna i externa (plasmòlisis); i que la concentració salina molt diluïda del medi (hipotònica) fa que les cèl·lules absorbeixin aigua.

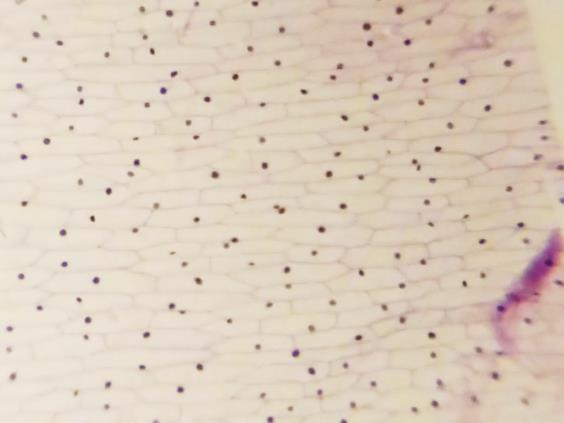
[picture p57: figure]

Materials
- Microscopi
- Ceba
- Portaobjectes i cobreobjectes
- Comptagotes

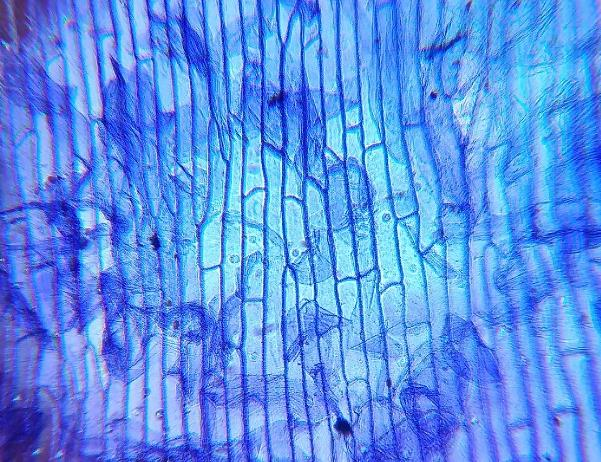
[picture p58: figure]

- Solució salina: hipertònica (6% NaCl), hipotònica (aigua destil·lada)
- Bisturí
- Blau de metilè (0.5-1.0% solució stock, diluir a 1:4 amb H20).
- Pinces de dissecció
- Paper de filtre
- Vidre de rellotge / Placa de Petri

Protocol
1. Tallar una ceba a quarts; en un de els quarts, separar les capes formen la ceba i, en la seva cara interna, separar l'epidermis (el teixit transparent que recobreix el full)
2. Col·locar l’epidermis sobre un portaobjectes, tenint cura de que el teixit quedi estirat.
3. Repetir el pas anterior, per a obtenir un total de 3 portaobjectes amb mostra. Retolar les mostres com a : tinció, hipotònic i hipertònic.
4. Mostra tinció:
a. Col·locar el portaobjectes sobre una placa Petri
b. Amb el comptagotes afegir blau de metilè, fins a cobrir la preparació.
c. Incubar 5 minuts a temperatura ambient
d. Rentar la preparació amb aigua destil·lada fins que aquesta surti transparent.
e. Col·locar un cobreobjectes i assecar la preparació per sota amb paper de filtre
f. Observa-al microscopi.
5. Mostra hipotònica/hipertònica:
a. Col·locar un cobreobjectes i assecar la preparació per sota amb paper de filtre.
b. Mentre s’observa la mostra sota el microscopi, afegir amb comptagotes solució hipotònica o hipertònica, mentre que per l’extrem oposat s’absorbeix l’excedent de solució amb paper de filtre.

### CÈL·LULA VEGETAL: ESTOMES

L'estoma és una estructura vegetal que regula l'intercanvi de gasos, format per un mínim de dues cèl·lules especialitzades anomenades cèl·lules oclusives i que deixen una obertura entre elles anomenada ostíol. L'ostíol és un porus que condueix a un ampli espai intracel·lular fent possible així l’intercanvi de CO2 i O2. Així mateix, l’ostíol també permet la transpiració de vapor d’aigua. La seva obertura es fotodepenent (llum=obert).
La forma, el nombre d'estomes i la seva disposició en les fulles és una característica de cada espècie i és molt variable.

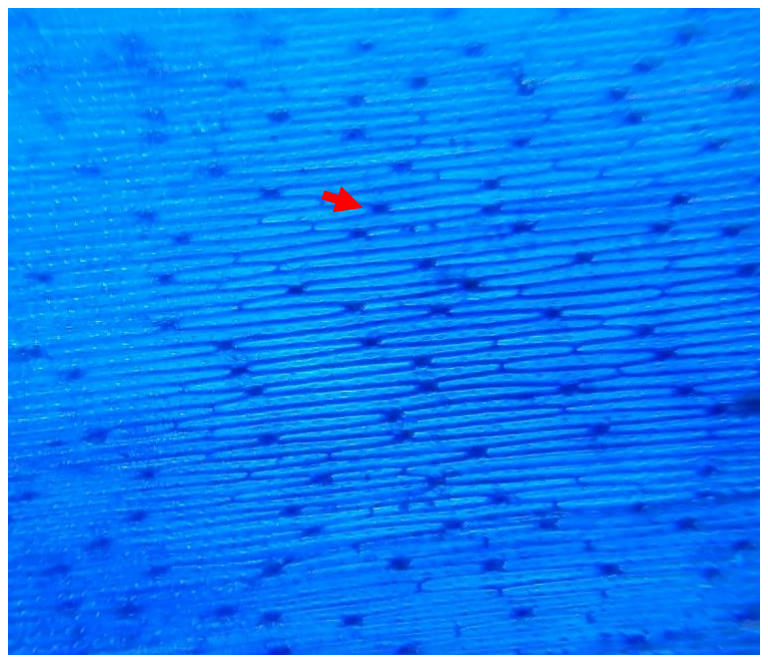
[picture p59: figure]

Materials
- Microscopi
- Portaobjectes i cobreobjectes
- Pinces
- Bisturí
- Comptagotes
- Porro

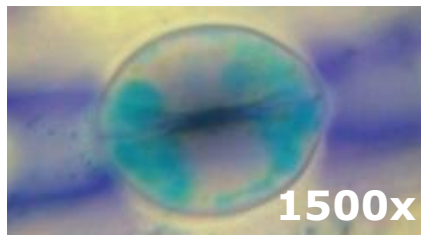
[picture p60: figure]

- Blau de metilè (0.5-1.0% solució stock, diluir a 1:4 amb H20).
- Aigua destil·lada
- Vidre de rellotge / Placa de Petri

Protocol
1. A la zona verda del porro, tallar una part petita (2x2cm) de la fulla i separar l'epidermis.
2. Col·locar l’epidermis en un portaobjectes, on prèviament hi ha 3 gotes d’aigua per tal de facilitar-ne la extensió.
3. Assecar l’aigua excedent amb paper de filtre i col·locar sobre la placa de Petri
4. Afegir blau de metilè i incubar durant 5 minuts a temperatura ambient. Vigilar que la mostra no s’assequi, afegint mes colorant si es necessari.
5. Amb un comptagotes, netejar l’excés de colorant.
6. Col·locar sobre la preparació un cobreobjectes evitant que es formin bombolles.
7. Visualitzar al microscopi.

### CÈL·LULA VEGETAL: AMILOPLASTS

Un amiloplast és un tipus de d’orgànul que es troba només en les cèl·lules vegetals i es seu contingut de grànuls de midó. És el responsable de l'emmagatzematge de l'amilopectina, una forma de midó, via la polimerització de la glucosa.

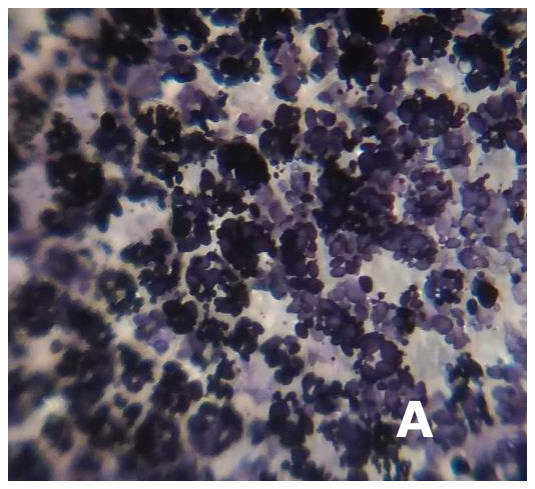
[picture p61: figure]
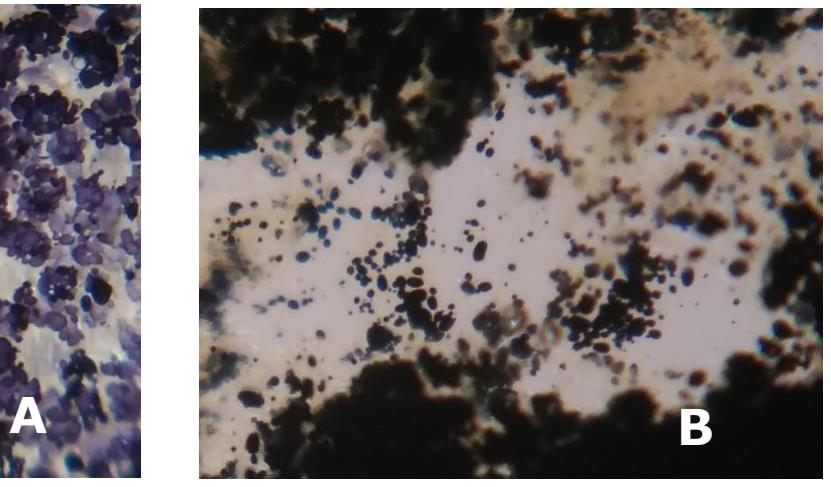
[picture p62: figure]

En la imatge A s’observa un tall molt prim de patata tenyit amb lugol. Els amiloplasts es troben empaquetats. En la imatge B es poden veure els amiloplasts alliberats, com a conseqüència del raspat.

Materials
- Microscopi
- Portaobjectes i cobreobjectes
- Pinces
- Bisturí
- Comptagotes
- Patata / Llegum / Llavor / Plàtan
- Solució de lugol
- Aigua destil·lada
- Vidre de rellotge / Placa de Petri

Protocol
1. (A) Tallar un tros molt prim de patata¹
(B) Raspar amb la punta del bisturí.
2. Amb cura, depositar el producte obtingut en un portaobjectes realitzant una extensió.
3. Fixar la mostra per assecat a temperatura ambient (3 min.)
4. Afegir una gota de lugol i incubar a temperatura ambient durant 3 minuts.
5. Rentar suaument amb aigua destil·lada.
6. Col·locar un cobreobjectes i comprimir suaument la preparació amb els dits.

1 Es poden raspar diferents llavors, patata, plàtan o llegums (mongeta, pèsol, fesol, blat de moro, etc.) realitzant el procés similar al del raspat de la patata.

### PROTOZOUS

Els protozous són éssers unicel·lulars eucariòtics de nutrició heteròtrofa, que necessiten viure en un medi humit. Alguns són paràsits i produeixen malalties com la malària. D’altres, viuen en aigua dolça o salada, formant part del plàncton.

Per desplaçar-se pel medi aquàtic, utilitzen pseudòpodes, cilis o flagels. Concretament, els ciliats d’aigua dolça posseeixen un vacúol pulsatiu amb funció excretora i osmoreguladora. Quan les condicions del medi es tornen adverses, com és el cas d'una dessecació, produeixen un embolcall resident i redueixen al mínim la seva activitat metabòlica, fins que les condicions ambientals tornant a ser les adients.

La seva reproducció més freqüent és l'asexual, per bipartició, encara que alguns presenten reproducció sexual per conjugació.

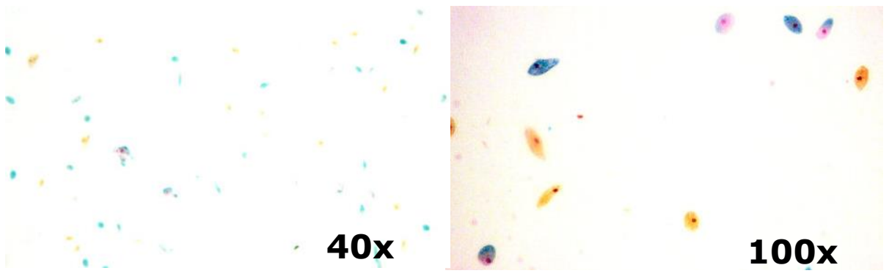
[picture p63: figure]

Materials
- Microscopi
- Portaobjectes i cobreobjectes
- Comptagotes
- Paper de filtre
- Vas de precipitats 250/500 ml
- Blau de metilè 0.05%
- Fullaraca, fulles externes d'enciams, bledes, coliflor, etc.

Protocol
A) Cultiu
1. Col·locar dins el vas de precipitats fullaraca
2. Afegir aigua fins a un dit per sota de la vora.
3. Deixar reposar el cultiu uns 15 dies a temperatura ambient. El vas de precipitats es pot tapar amb paper de plata i mantenir fora de la llum directe.
B) Observació
4. Amb un comptagotes, agafar una mostra del cultiu.
5. Dipositar la mostra en un portaobjectes i tapar amb un cobreobjectes.
6. Mentre s’observa la mostra al microscopi, afegir suaument per un extrem del cobreobjectes blau de metilè amb un comptagotes.

### FONGS

Els fongs són cèl·lules eucariotes, i poden estar organitzats com unicel·lulars (llevats) o pluricel·lulars (floridures). El primers els podem trobar en molts aliments, com algunes cerveses del tipus Wiezenbier.
El fongs que produeixen floridures, son fàcilment visualitzables al microscopi i es poden trobar en formatges o en aliments en descomposició. Estan formats d'hifes, unes estructures filamentoses, separades l'una de l'altra per unes divisions anomenades septes. Al conjunt d'hifes se l'anomena miceli.

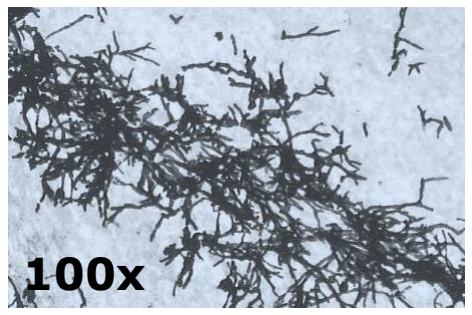
[picture p64: figure]

Materials
- Microscopi
- Portaobjectes i cobreobjectes
- Comptagotes
- Paper de filtre
- Blau de metilè 0.05%

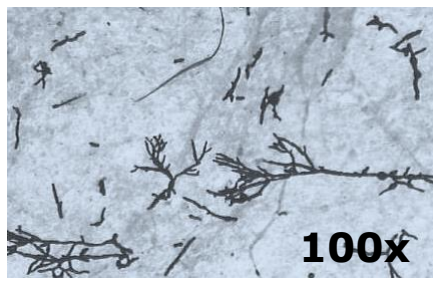
[picture p65: figure]

- Pa de motlle, salsa de tomàquet, formatge, medi agarosa en placa de Petri

Protocol
IMPORTANT: Les espores produïdes pels fongs poden ser perilloses per la salut i provocar malalties. Es necessari prendre les mesures de seguretat necessàries. Això implica l’ús de guants i mascareta durant la manipulació de la mostra i la inactivació del material contaminat mitjançant la immersió en lleixiu al 5% durant 10 minuts.
A) Cultiu
1. Posar dins d’un recipient hermètic una llesca de pa de motlle o salsa de tomàquet. (Opcional: Alguns formatges ja tenen els fongs desenvolupats a la capa externa)
2. Tancar el recipient i deixar reposar un mínim de 7 dies, evitant calor o llum directe.
3. Quan els fongs siguin de la mida desitjada, obrir amb compte utilitzant guants i mascareta per evitar respirar les espores.
B) Observació
7. En un portaobjectes, dipositar una gota d’aigua destil·lada.
8. Raspar amb un bisturí el fong i dipositar el producte al portaobjectes, barrejant-lo amb la gota d’aigua.
9. Tapar amb un cobreobjectes.
10. Col·locar en un extrem del cobreobjectes paper de filtre i afegir blau de metilè per el costat contrari, fins que tota la mosta quedi tenyida.
11. Incubar 2 minuts a temperatura ambient
12. Eliminar l’excés de tinció amb paper de filtre
13. Observar al microscopi
100x | 100x
