Curedbio/Microscope/Assembly_guide_v012_ESP.pdf

# SMARTPHONE MICROSCOPE

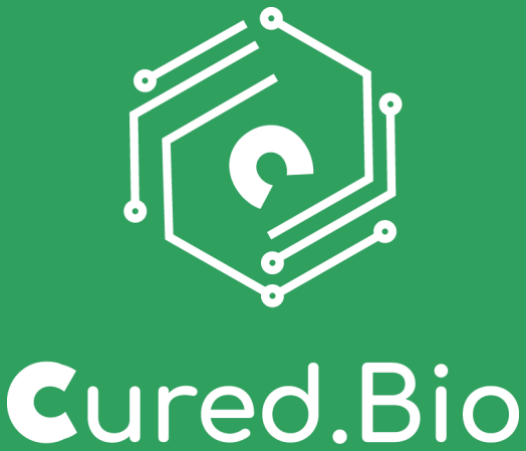
[picture p66: figure]

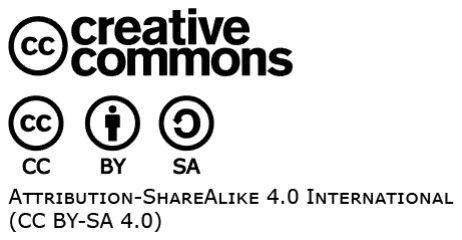
[picture p67: figure]

Smartphone Microscope

Editado por Cured.Bio

Versión 0.1.2

Barcelona, 2018

Para el ensamblaje del Smartphone Microsope no se necesitan herramientas. Su ensamblaje lleva entre 10 y 15 minutos y puede ser fácilmente desmontado.

No obstante, es posible establecer una estructura fija, se recomienda añadir algún
tipo de cola adhesiva en las zonas marcadas como | .

Como adhesivo, se recomienda usar cola blanca, hot glue o resina epoxy.

Es importante asegurarse que algunas zonas estén bien unidas. Dichas uniciones, se hallan
marcadas con | .

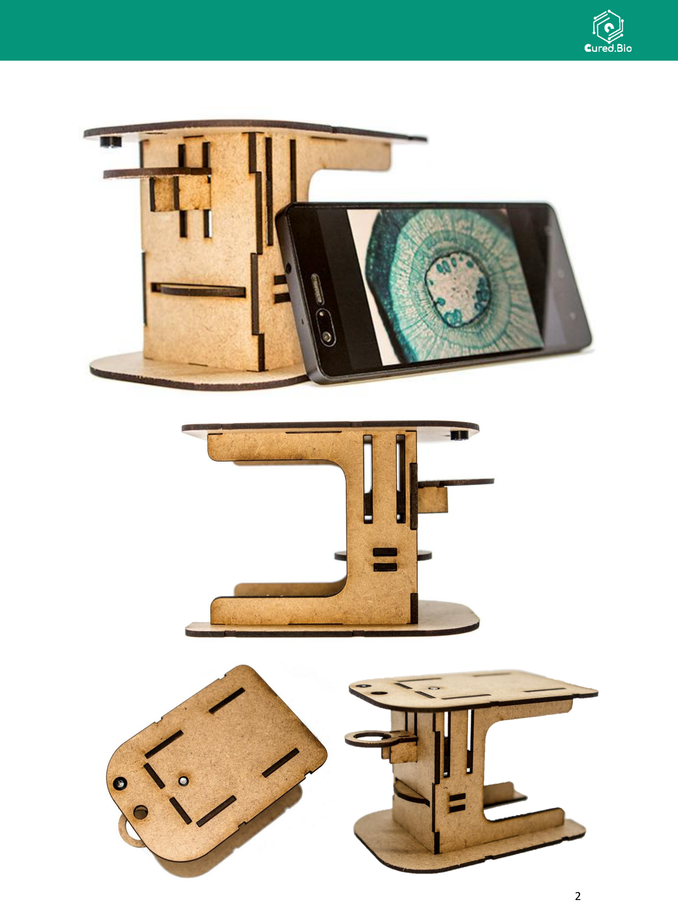
[picture p68: page 4]
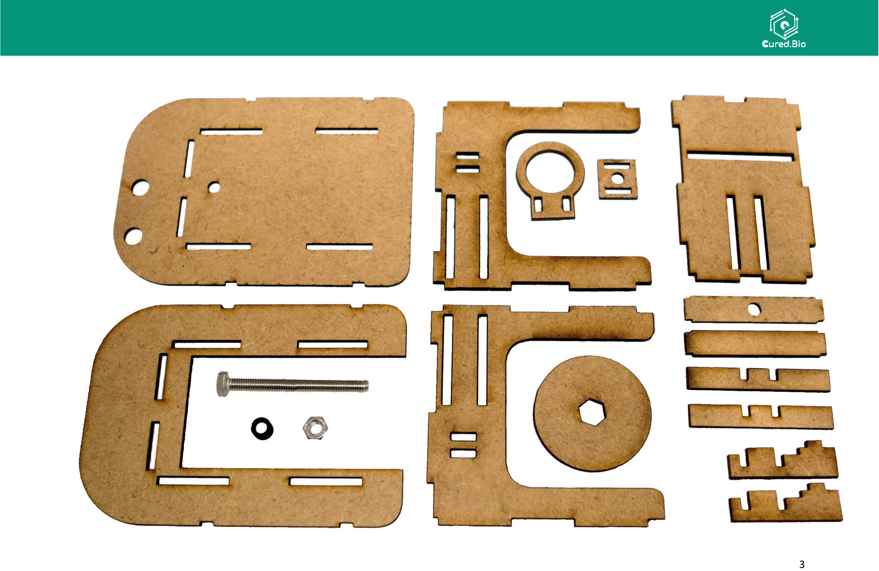
[picture p69: page 5]

3

2F1
G

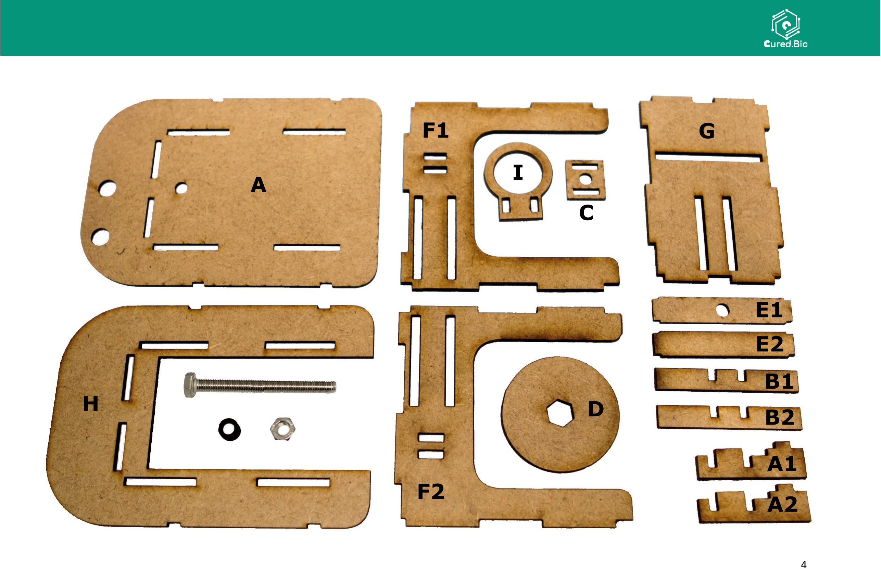
[picture p70: page 6]

4

A

A

1

A

2

B2B1

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
### PASO 1

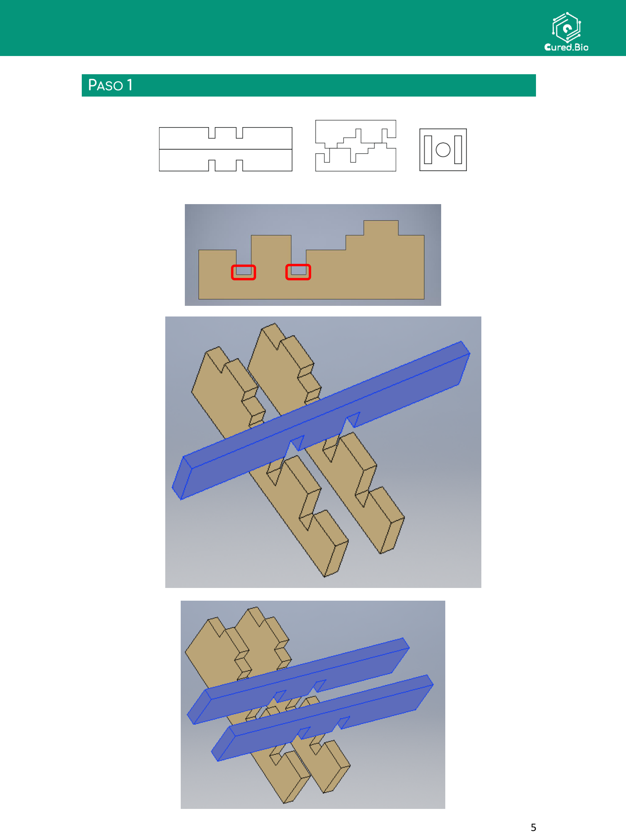
[picture p71: page 7]
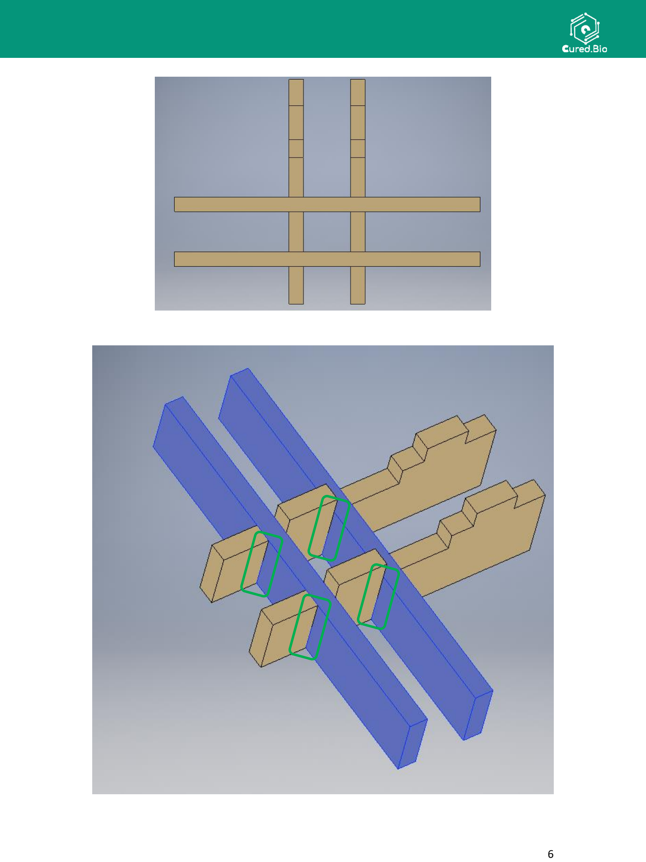
[picture p72: page 8]
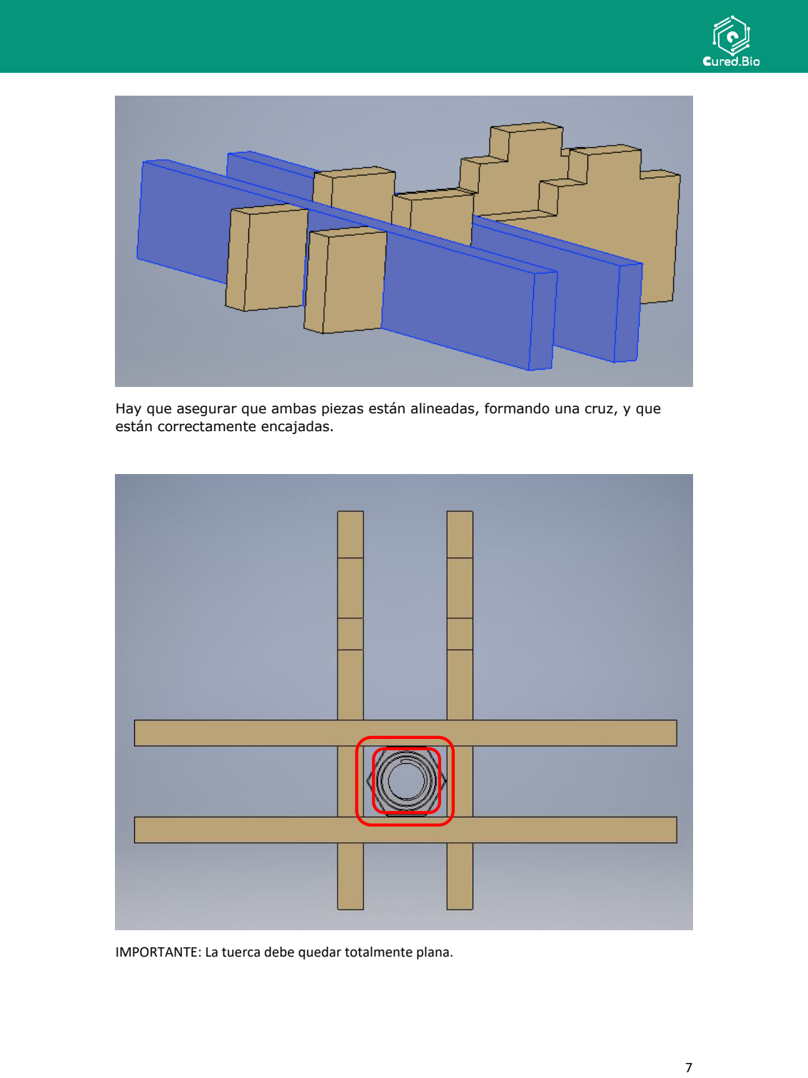
[picture p73: page 9]

Hay que asegurar que ambas piezas están alineadas, formando una cruz, y que están correctamente encajadas.

IMPORTANTE: La tuerca debe quedar totalmente plana.

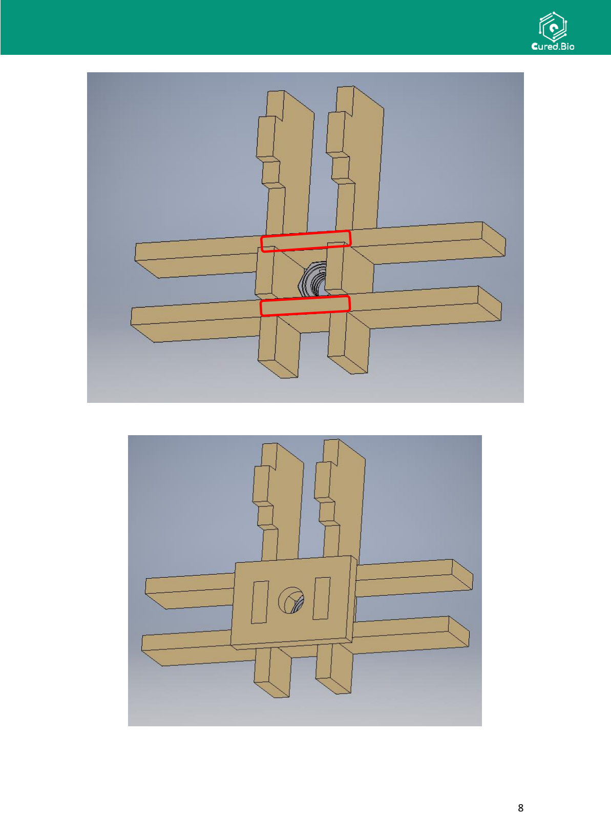
[picture p74: page 10]

### PASO 2

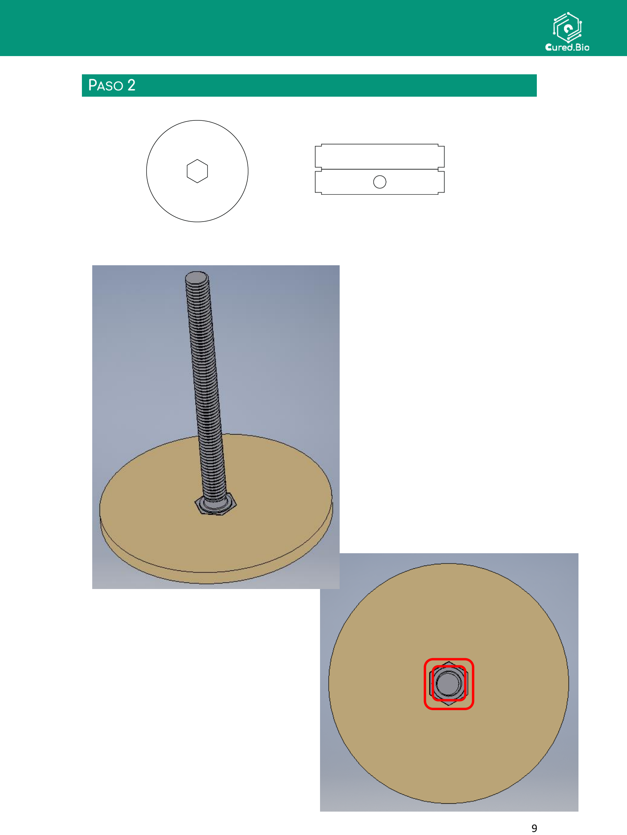
[picture p75: page 11]
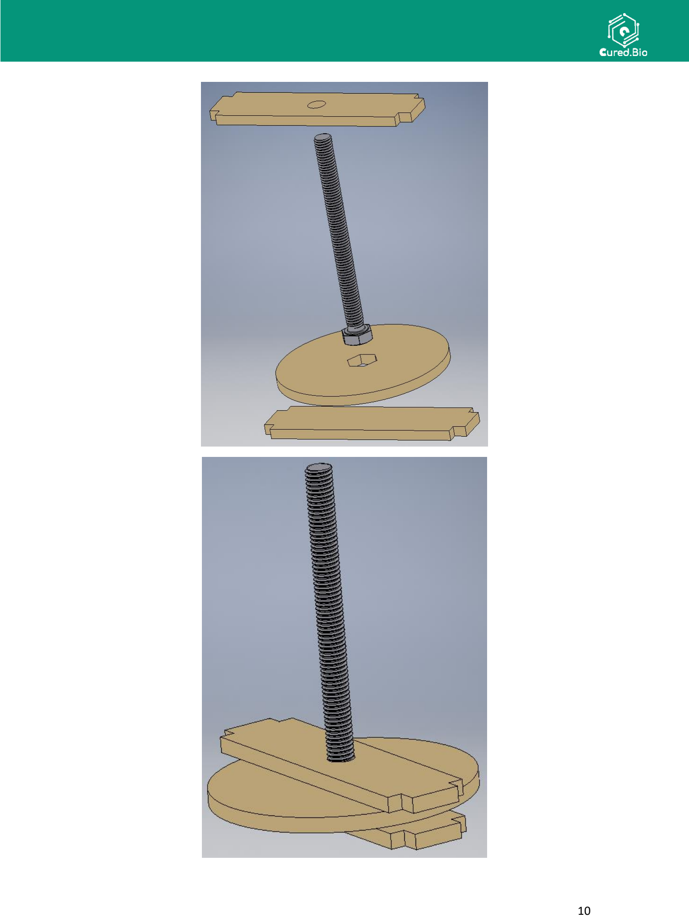
[picture p76: page 12]

### PASO 3

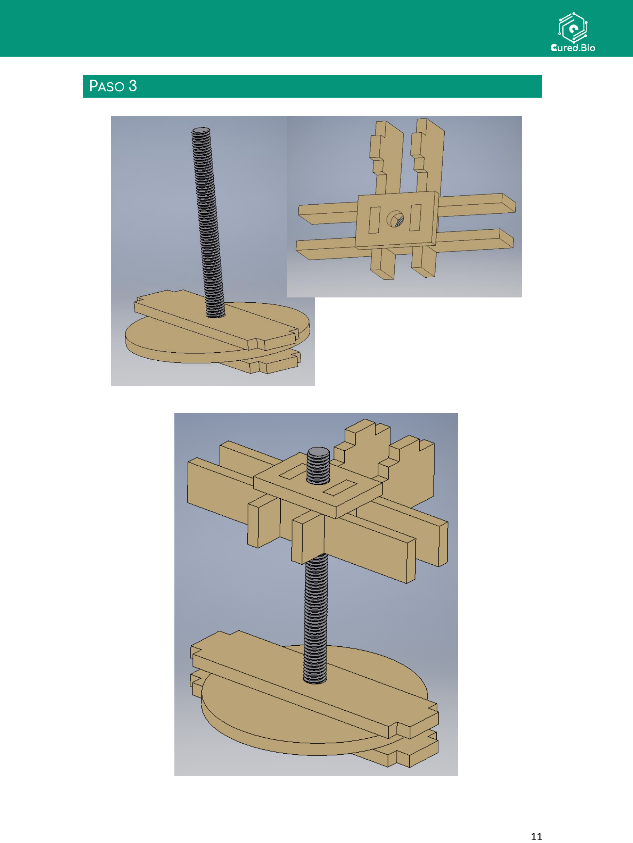
[picture p77: page 13]

### PASO 4

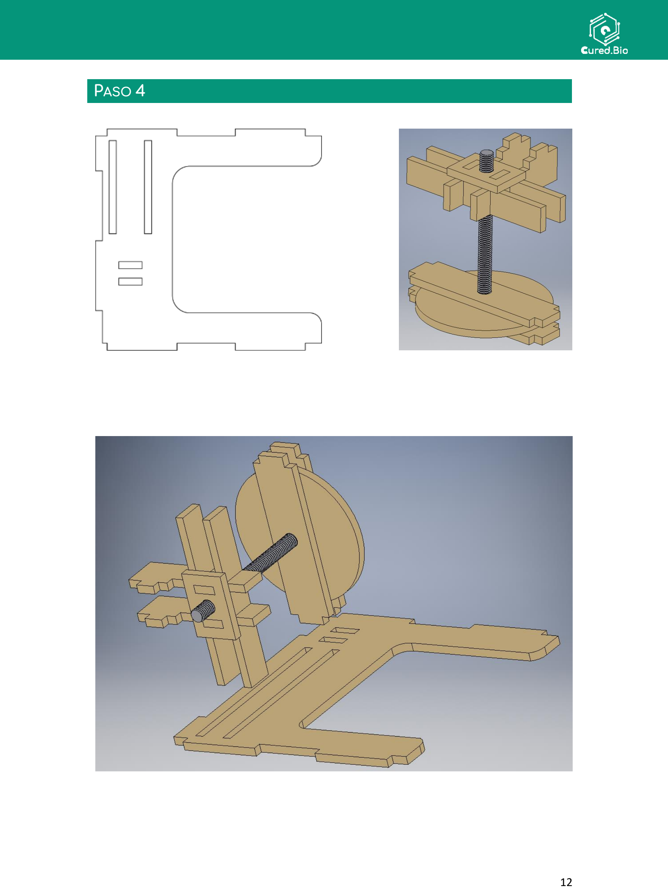
[picture p78: page 14]
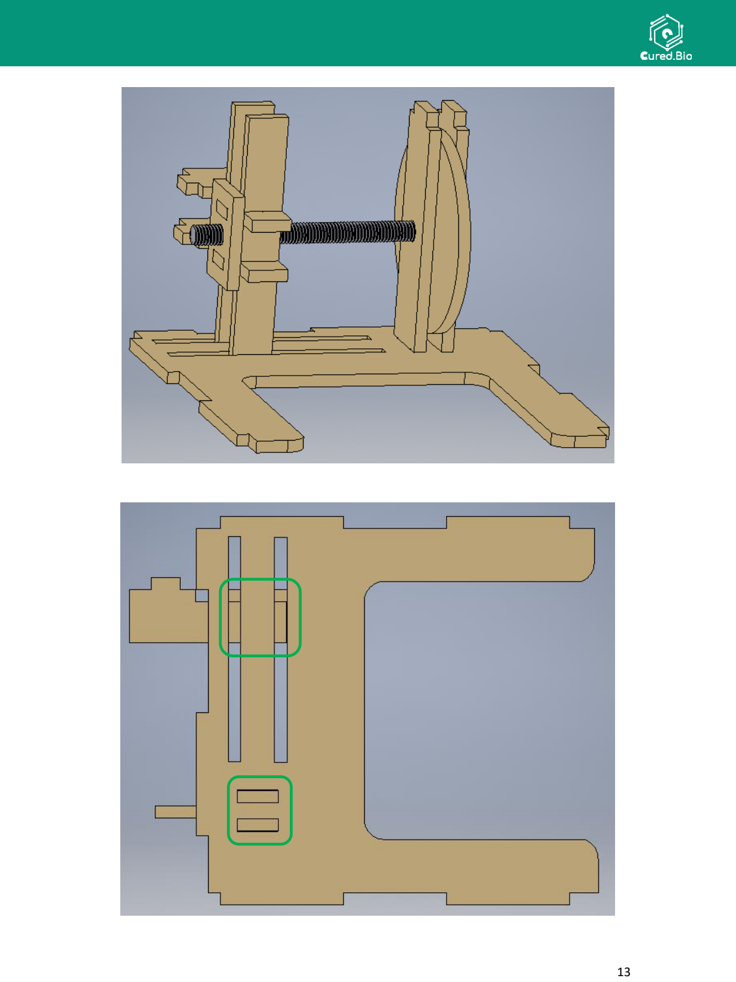
[picture p79: page 15]
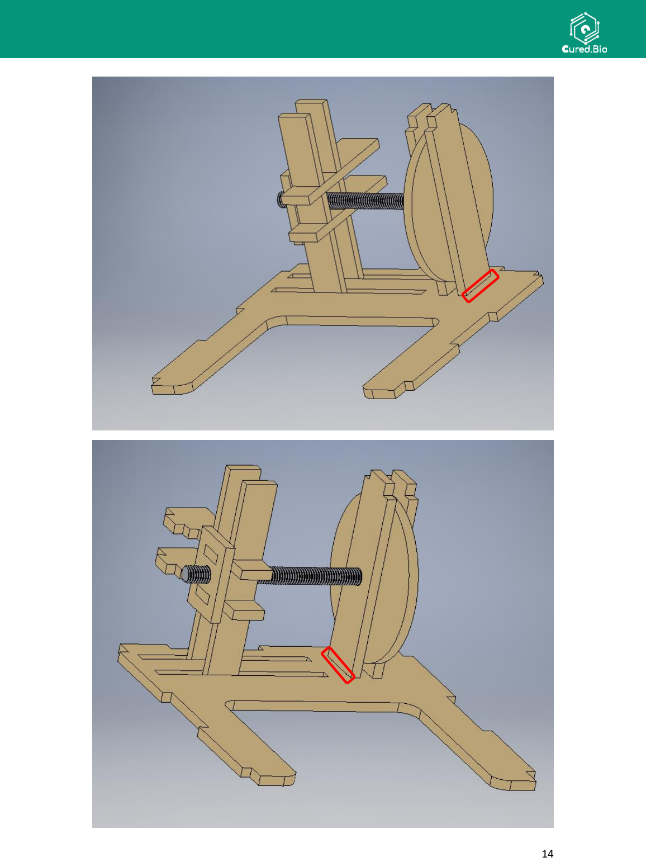
[picture p80: page 16]

### PASO 5

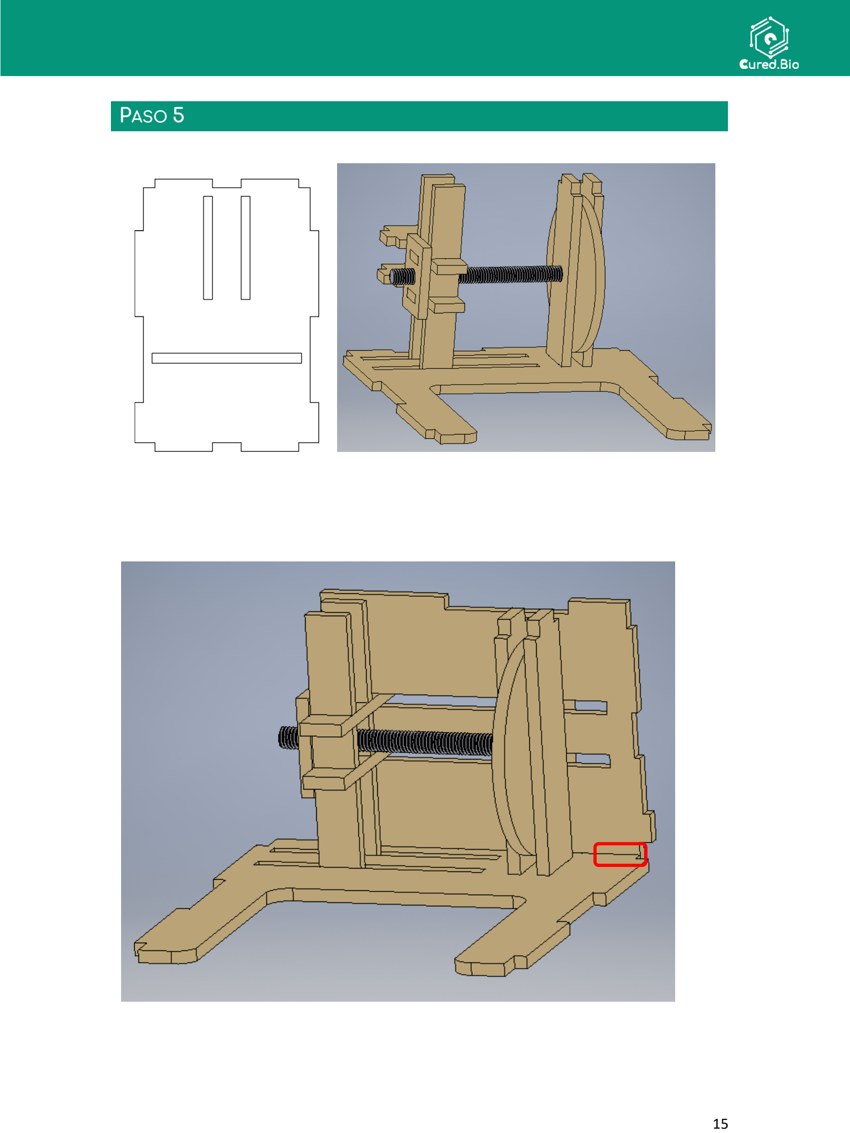
[picture p81: page 17]

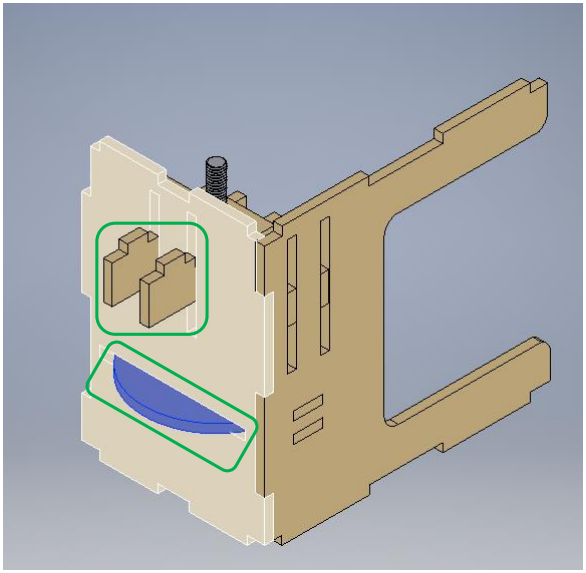
[picture p82: figure]

### PASO 6

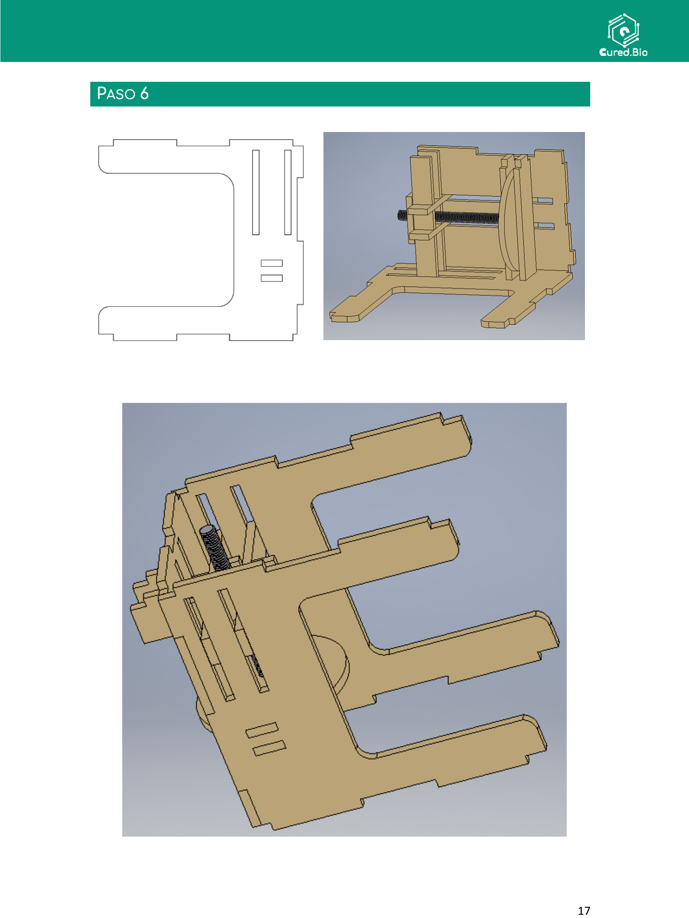
[picture p83: page 19]
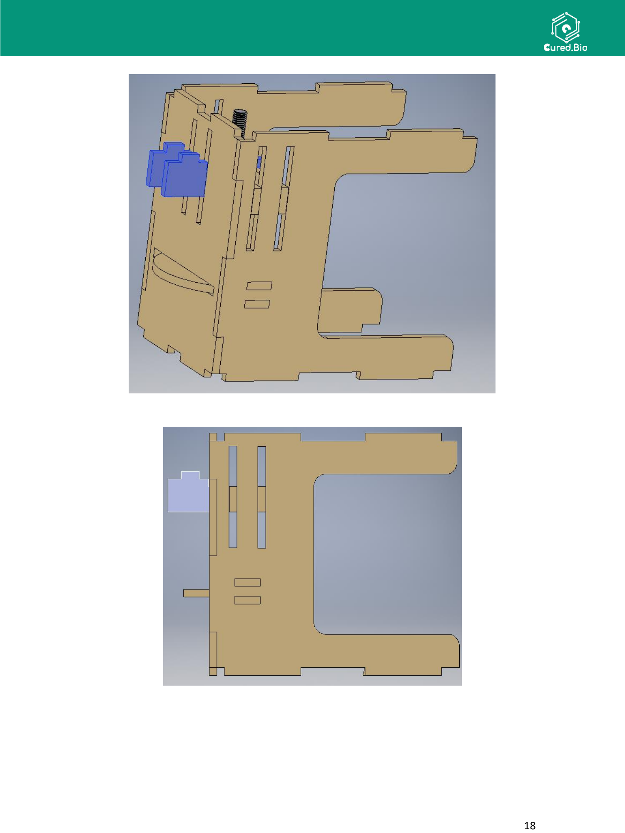
[picture p84: page 20]
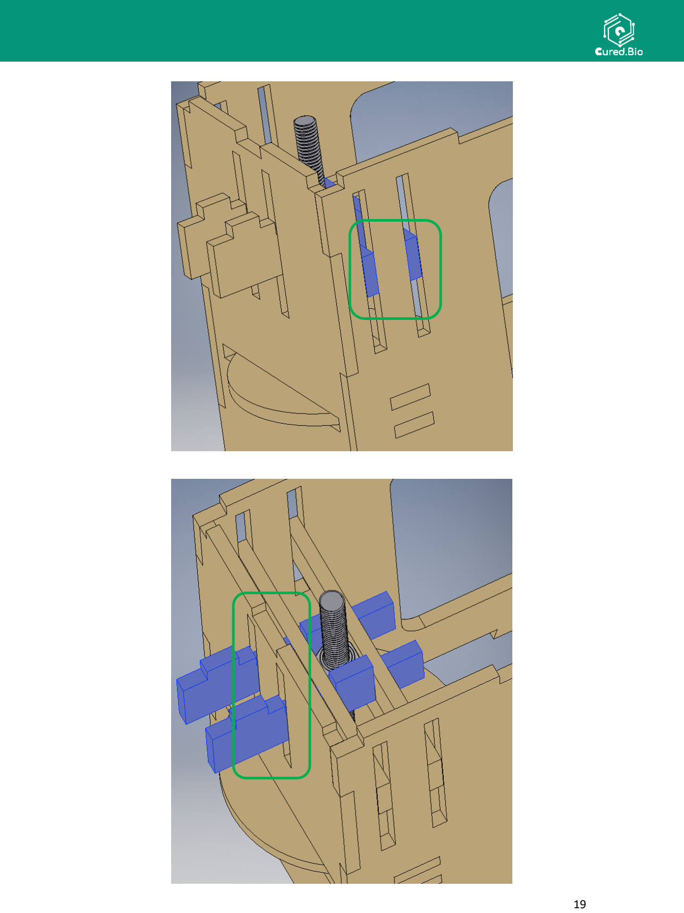
[picture p85: page 21]

### PASO 7

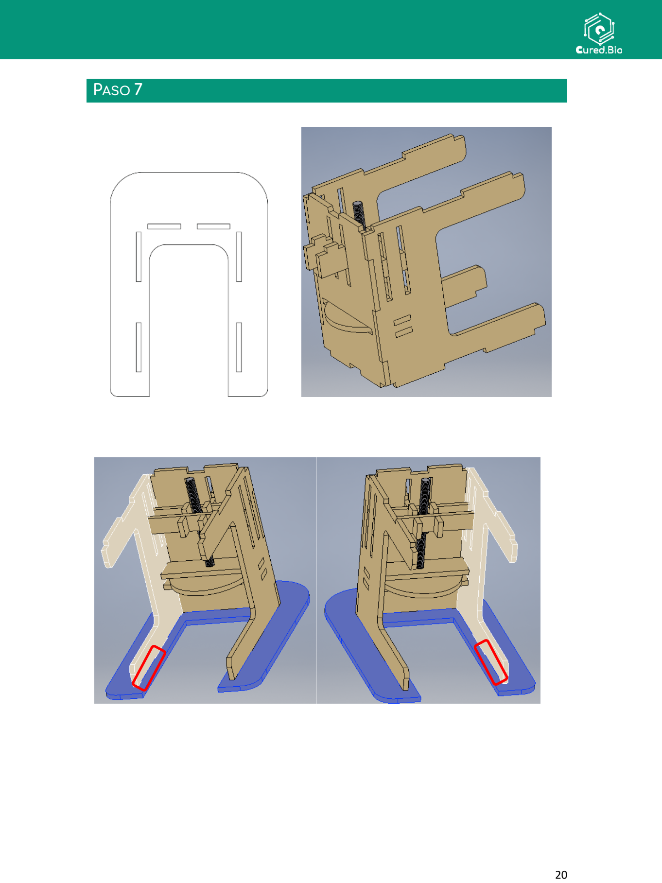
[picture p86: page 22]

### PASO 8

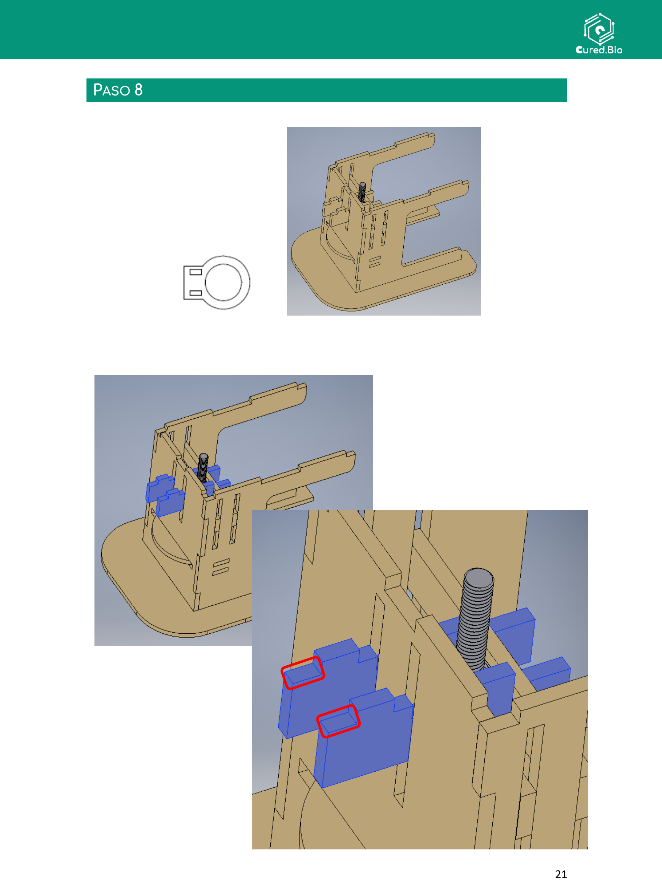
[picture p87: page 23]

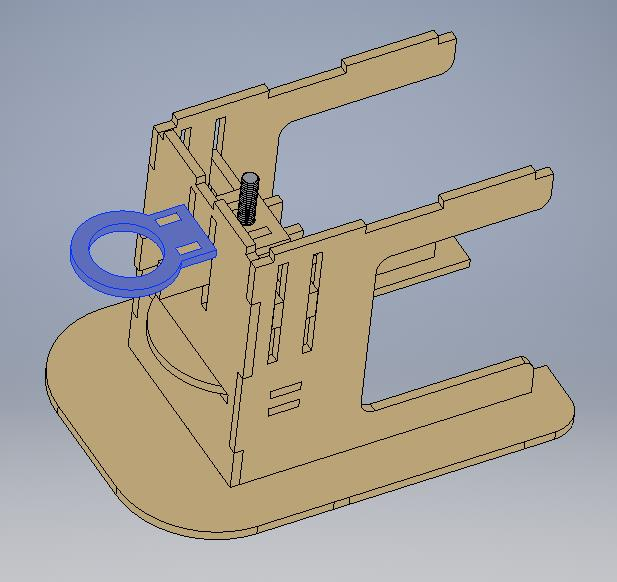
[picture p88: figure]

### PASO 9
